glocklueng/bldc-hardware/design/BOM_2.xls

Mouser # | Description | Quant | Label on the Schematic/PCB | Comment | Price
511-STM32F407ZGT6 | STM32F4 MCU | 1 | U1
579-TC2117-3.3VDBTR | VREG | 1 | U2
595-DRV8302DCA | MOSFET Driver | 2 | U3
595-SN65HVD232DR | CAN Transceiver | 1 | U401
926-LM73CIMK-0/NOPB | Temp sensor | 4 | U301 | Only on REV 4.5. Rev 4.6 uses an NTC ressitor.
81-NCP18XH103F03RB | NTC resistor (temp sensor) | 4 | R1 | Rev 4.6 and onwards
652-SDR0805-220ML | Power Inductor | 2 | L1
798-UX60R-MB-5ST | Mini-USB | 1 | X1
815-ABM3B-8.0-10-1UT | Crystal 8MHz, 10PPM | 1 | X2
FDBL86210_F085 | MOSFET 150V 169A | 12 | Q1-Q6
71-WSLP27261L000FEA | Shunt 1mOhm | 6 | R53,R54
576-SMAJ5.0A | TVS diode 5V | 2 | D5 | Rev 4.7 and onwards
771-PMEG6020ER-115 | Shottky 60V 2A | 2 | D4 | Voltage and current important
581-TPSB107K006R0400 | CAP 100u, 6.3V | 4 | C25,C33 | Voltage important
963-UMK316BBJ106ML-T | CAP 10u, 50V, 1206 | 16 | C1,C8,C9,C39,C40,C43,C44,C49 | Voltage important
810-CGA9P3X7S2A156M | CAP 15u, 100V, 2220 | 4 | C37,C51 | Voltage important
581-06035C104JAT2A | CAP 100n, 50V, 0603 | 8 | C2,C3,C27,C32 | Voltage important
80-C0805C224K5 | CAP 220n, 25V, 0805 | 6 | C28,C29,C30 | Voltage important
810-C1608X5R1C225M | CAP 2.2u, 16V, 0603 | 30 | C24,C10,C11,C12,C13,C14,C16,C17,C20,C31,C35,C41,C52,C401 | Voltage important
77-VJ0805V225MXJTBC | CAP 2.2u, 16V, 0805 | 4 | C18,C23 | Voltage important
 | Micro-JST 6PIN 2mm | 6 | P1,P2,P3
 | Micro-JST 4PIN 2mm | 1 | P101
81-GRM39X472J50D | CAP 4.7n, 50V, 0603 | 12 | C4-C7
81-GRM39X222J50D | CAP 2.2n, 50V, 0603 | 4 | C34, C36
81-GRM1885C2A150JA01 | CAP 15p, 100V, 0603 | 4 | C15,C38
81-GRM39C121J50 | CAP 120p, 50V, 0603 | 2 | C19
81-GRM18R71H682KA01J | CAP 6.8n, 50V, 0603 | 2 | C21
81-GRM18F51H223ZA01D | CAP 22n, 50V, 0603 | 2 | C22
81-GRM155R71C104KA88 | CAP 100n, 16V, 0402 | 2 | C301
859-LTST-C191KGKT | LED Green, 0603 | 10 | D1
859-LTST-C191KRKT | LED Red, 0603 | 10 | D2
720-LBQ39GN1P1351 | LED Blue, 0603 | 10 | D3
660-RK73H1JTTD4R70F | R 4.7ohm, 0603 | 12 | R28,R29,R34,R35,R42,R43
660-RK73H1JTTD1000F | R 100ohm, 0603 | 14 | R37,R38,R48-R51,R401
660-RK73H1JTTD2201F | R 2.2k, 0603 | 18 | R4,R5,R11,R12,R13,R22,R24,R27,R33
660-RK73H1JTTD3301F | R 3.3k, 0603 | 2 | R18
660-RK73H1JTTD1002F | R 10k, 0603 | 18 | R2,R7,R8,R9,R10,R20,R402
660-RK73H1JTTD1502F | R 15k, 0603 | 2 | R19
660-RK73H1JTTD1802F | R 18k, 0603 | 2 | R17
71-CRCW0603J-33K | R 33k, 0603 | 28 | R3,R23,R26,R30,R32,R36,R46
660-RK73H1JTTD2203F | R 220k, 0603 | 2 | R21
660-RK73H1JTTD3303F | R 330k, 0603 | 2 | R15
660-RK73H1JTTD1004F | R 1M, 0603 | 2 | R25
660-RK73H1JTTD22R0F | R 22R, 0603 | 4 | R103, R104
 | ArduinoDUE | 1
