glocklueng/bldc-hardware/design/BLDC_4.pdf

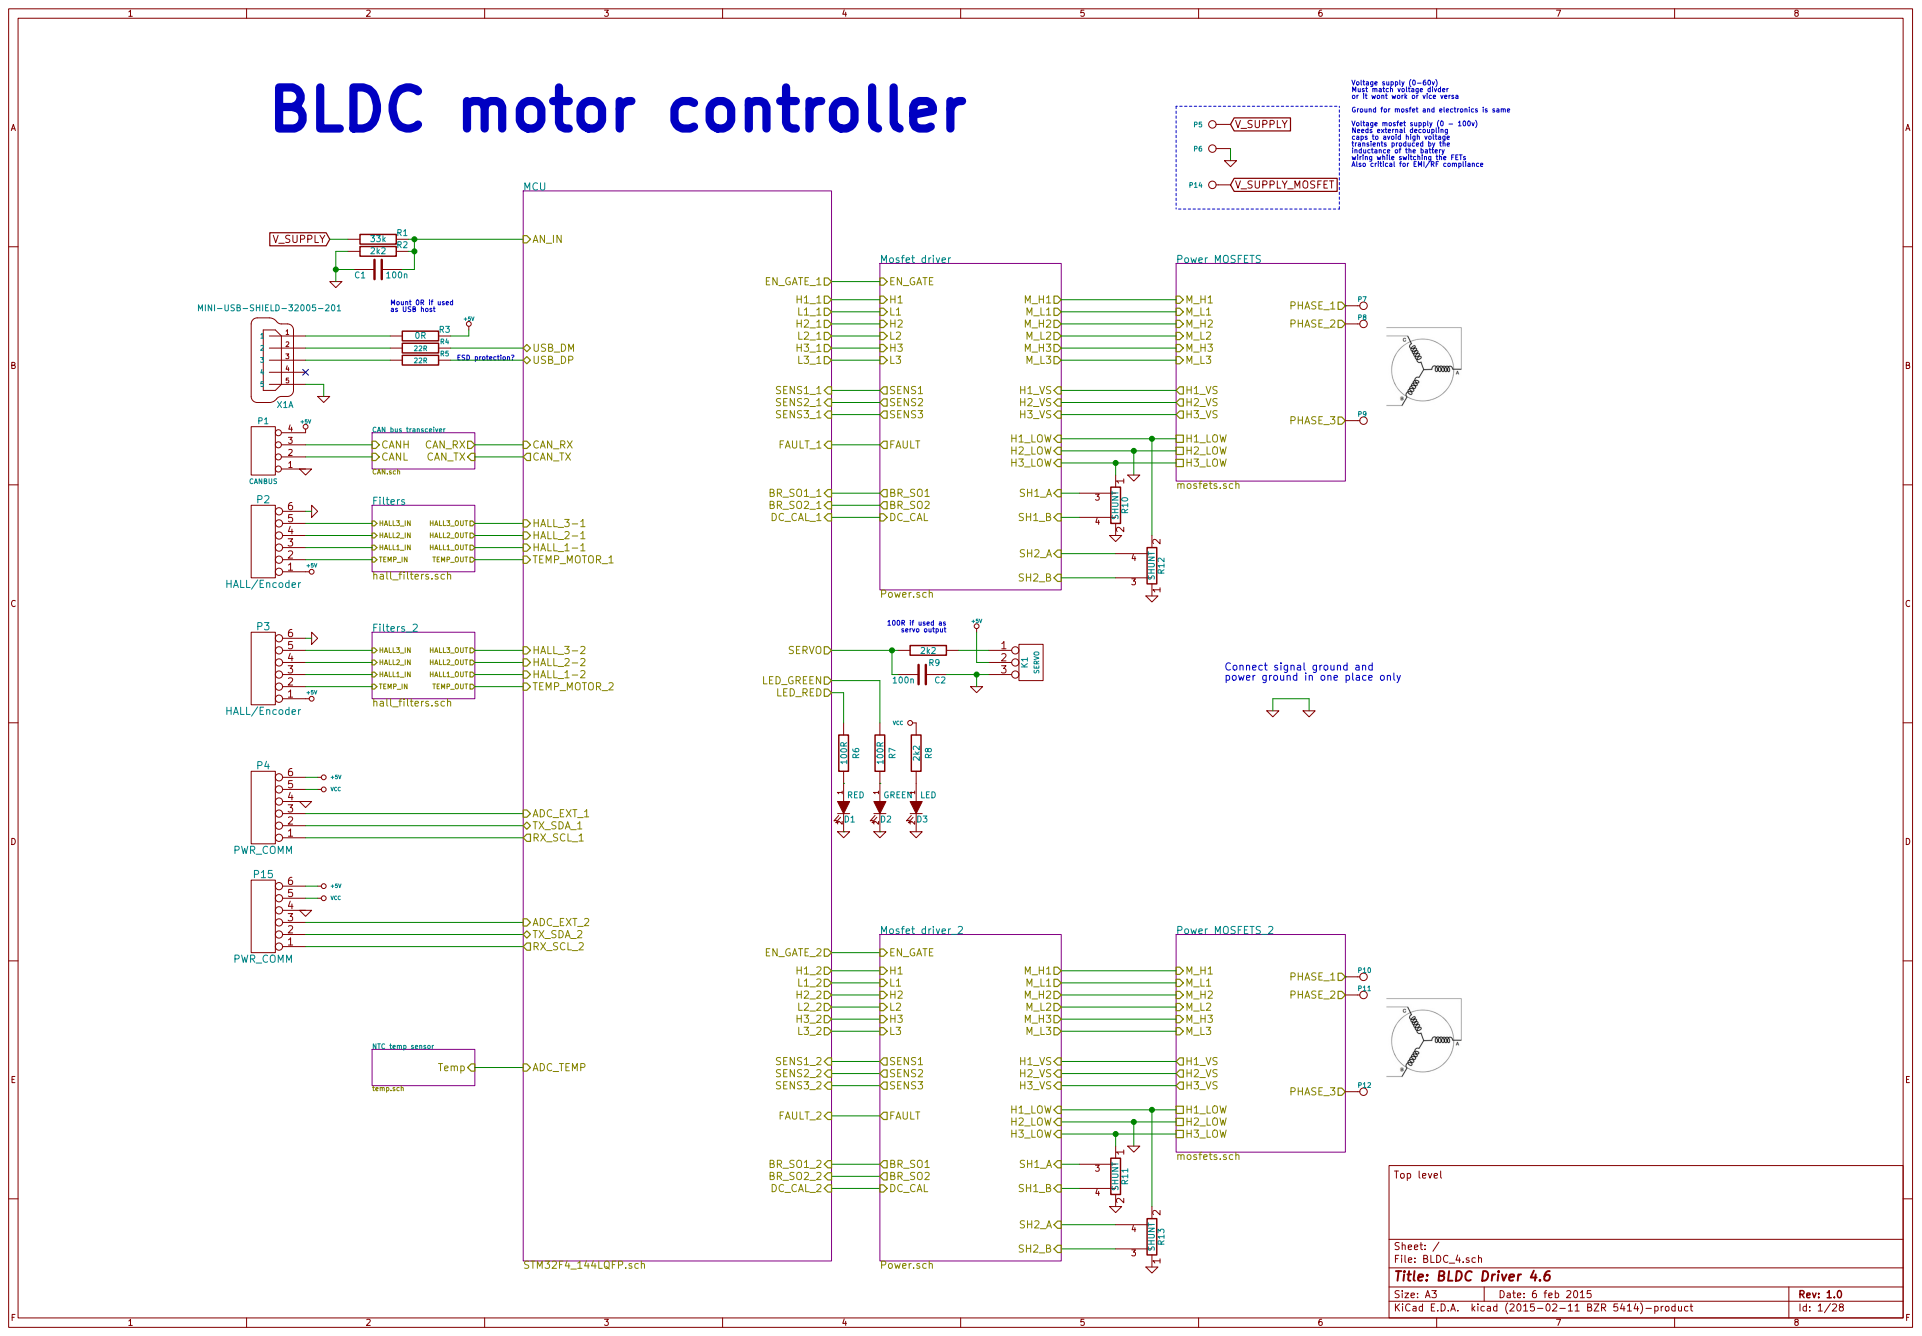
[picture p9: page 1]

Voltage mosfet supply (0 - 100v) Needs external decoupling
caps to avoid high voltage
transients produced by the

VCC Mosfet driver Power.sch FAULT DC_CAL
EN_GATE H1

File: BLDC_4.sch Sheet: / Top level 123456 P2 HALL/Encoder

power ground in one place only 123456 P3 HALL/Encoder

Connect signal ground and

Mosfet driver_2 Power.sch FAULT DC_CAL

Id: 1/28 Title: BLDC Driver 4.6

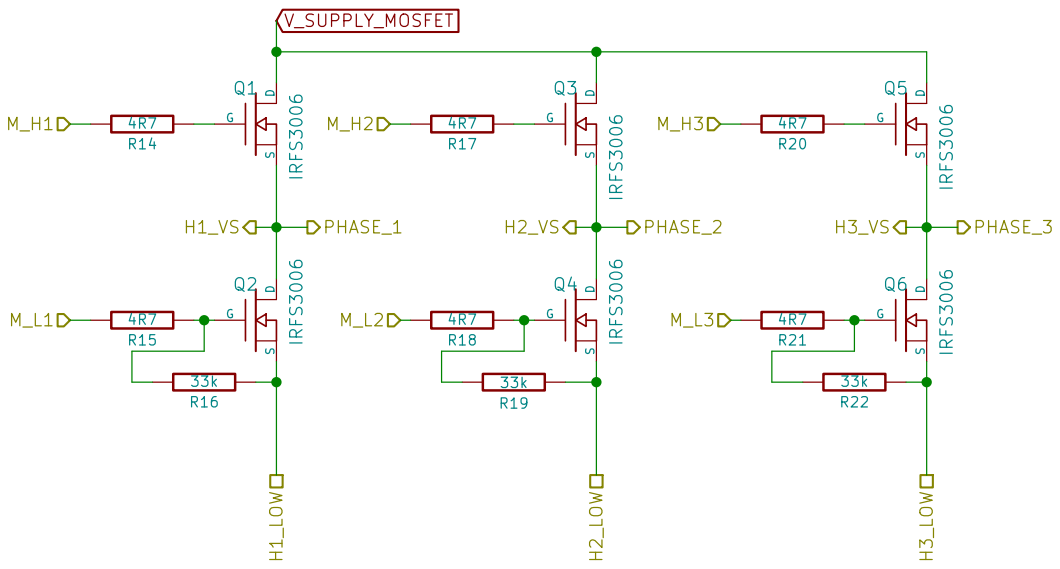
[picture p10: page 2]

33k V_SUPPLY_MOSFET
File: mosfets.sch Sheet: /Power MOSFETS/ R22

Id: 2/28 Title: BLDC Driver 4.6

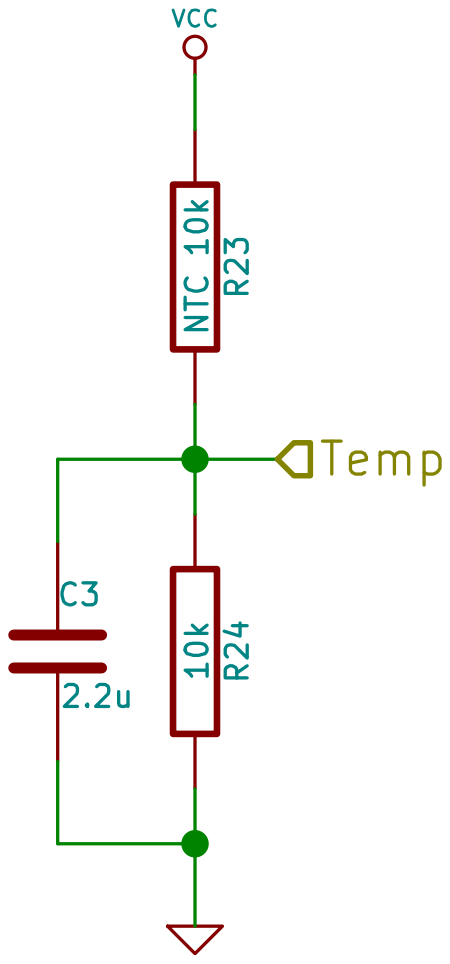
[picture p11: page 3]

Sheet: /NTC temp sensor/ R23 NTC 10k 10k R24 C3

File: temp.sch
Id: 3/28 Title: NTC resistor temperature sensor

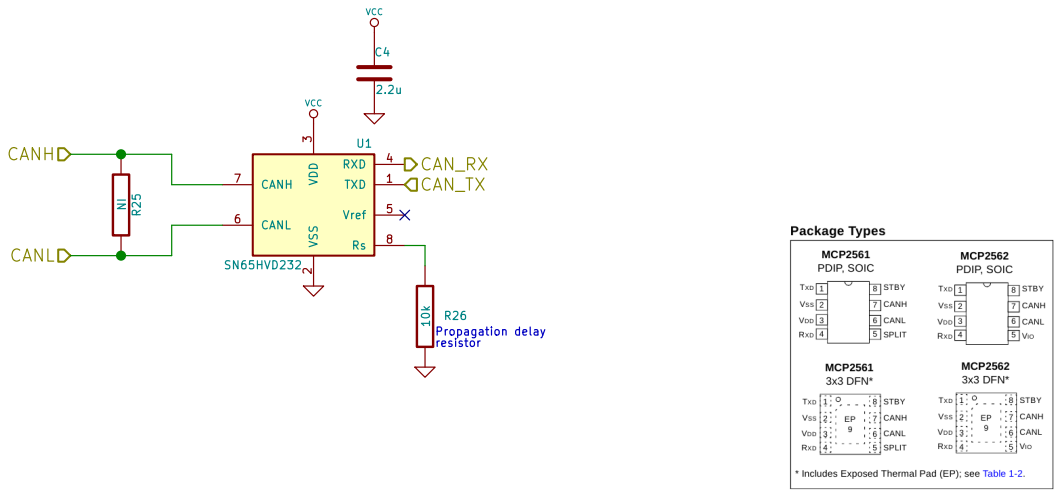
[picture p12: page 4]

3 RXD 4 Vref 5 CANL 6 CANH 7 Rs 8 U1 SN65HVD232

Id: 4/28 Title: CAN BUS transceiver File: CAN.sch Sheet: /CAN bus transceiver/

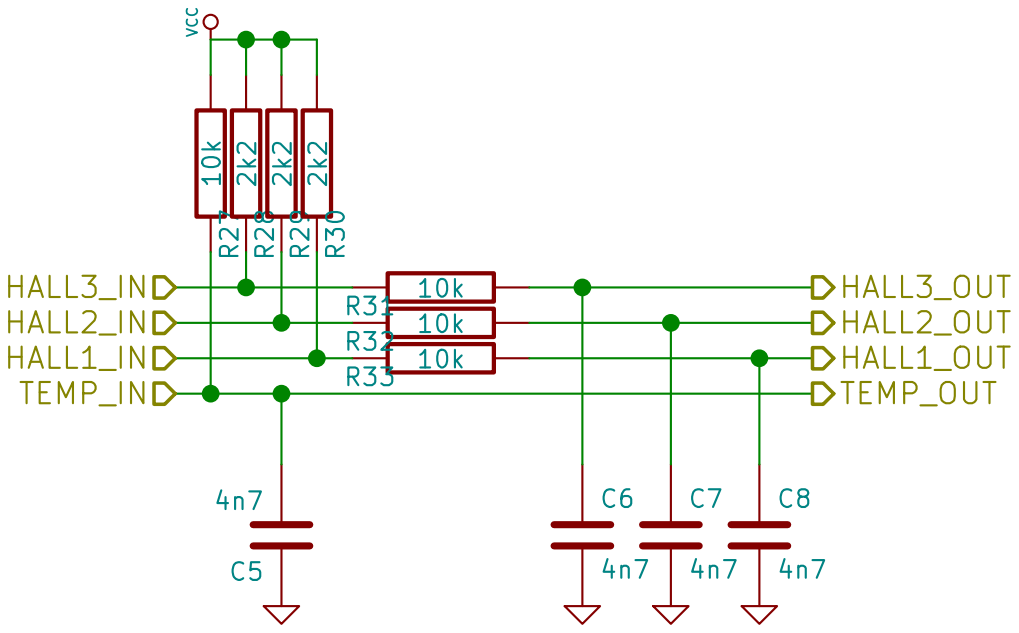
[picture p13: page 5]

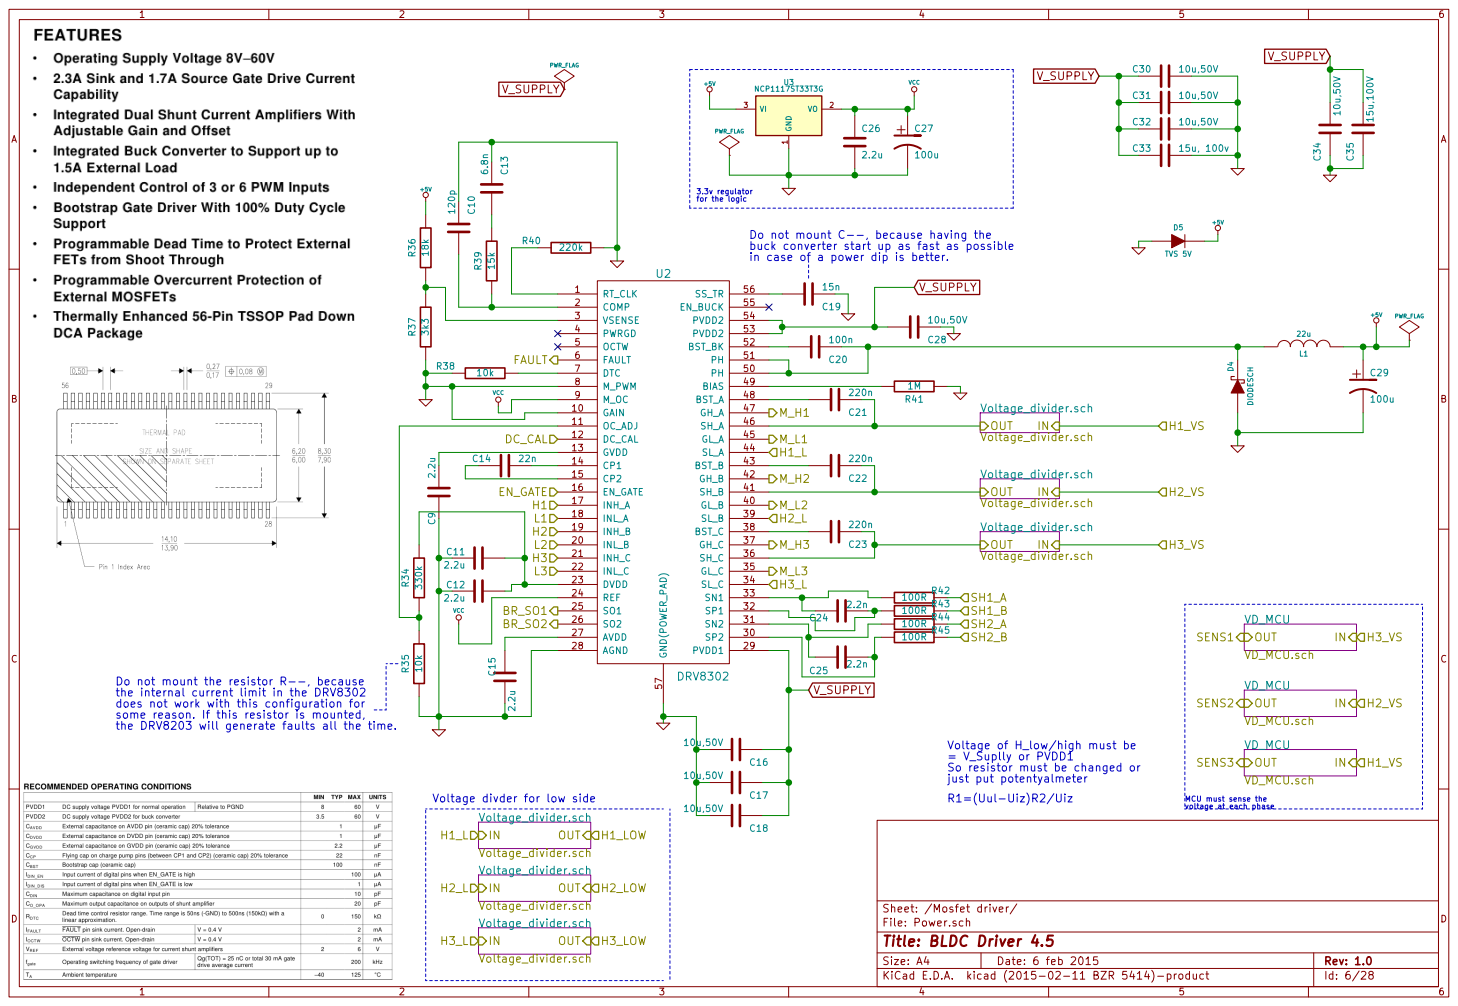
[picture p14: page 6]

for the logic Do not mount the resistor R--, because

+5V Do not mount C--, because having the
buck converter start up as fast as possible
in case of a power dip is better.

the internal current limit in the DRV8302
does not work with this configuration for
some reason. If this resistor is mounted,
the DRV8203 will generate faults all the time.

Voltage of H_low/high must be
= V_Suplly or PVDD1
So resistor must be changed or
just put potentyalmeter
R1=(Uul-Uiz)R2/Uiz

Voltage divder for low side

MCU must sense the
voltage at each phase

File: Power.sch Sheet: /Mosfet driver/
Id: 6/28 Title: BLDC Driver 4.5

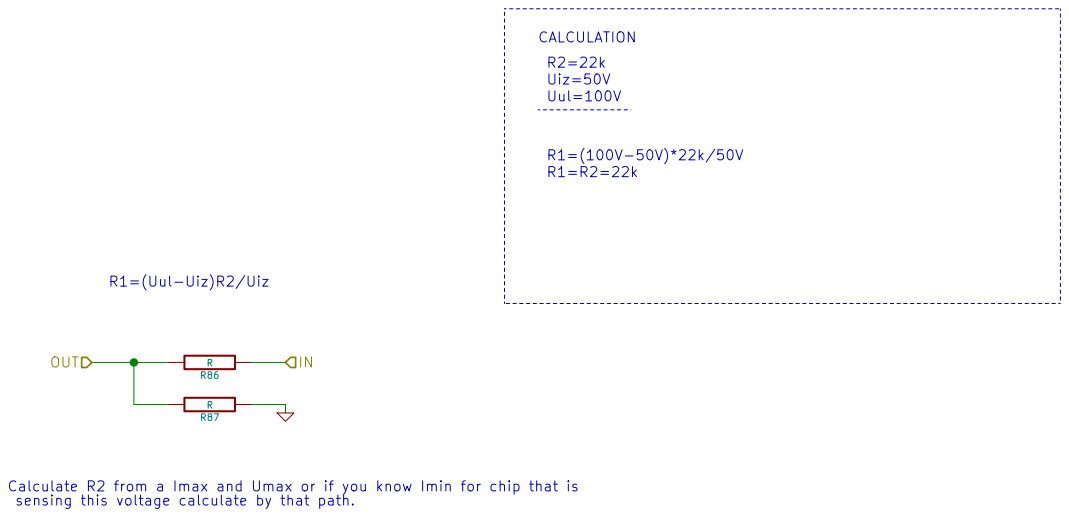
[picture p15: page 7]

Calculate R2 from a Imax and Umax or if you know Imin for chip that is
sensing this voltage calculate by that path.

Sheet: /Mosfet driver/Voltage_divider.sch/
File: Voltage_divider.sch
Id: 7/28 Title:

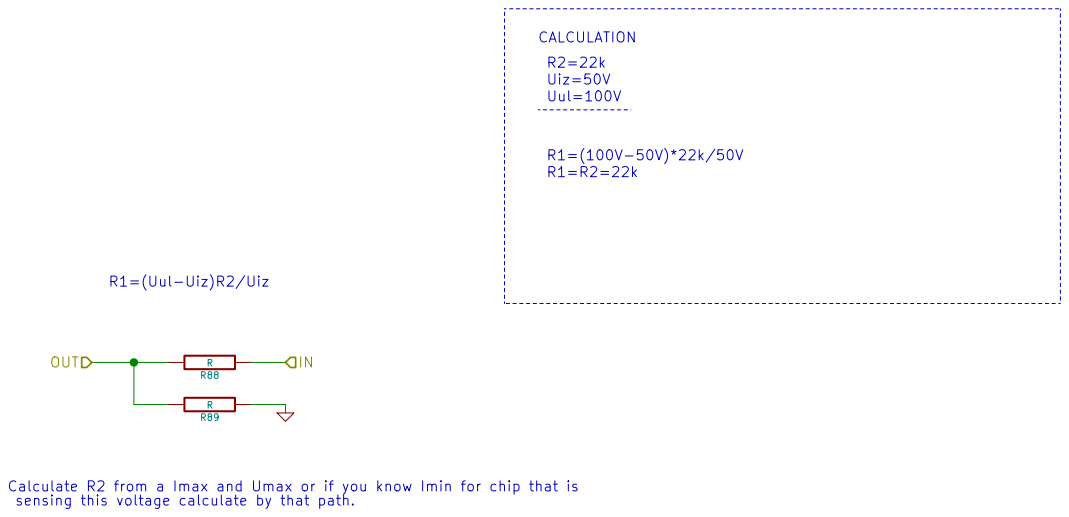
[picture p16: page 8]
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

Sheet: /Mosfet driver/Voltage_divider.sch/
File: Voltage_divider.sch
Id: 8/28 Title:

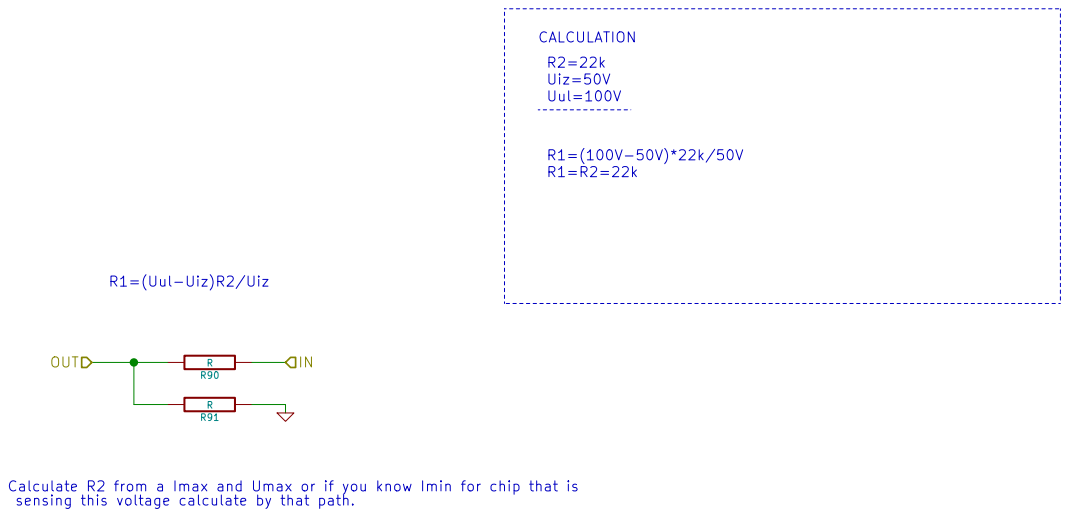
[picture p17: page 9]
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

Sheet: /Mosfet driver/Voltage_divider.sch/
File: Voltage_divider.sch
Id: 9/28 Title:

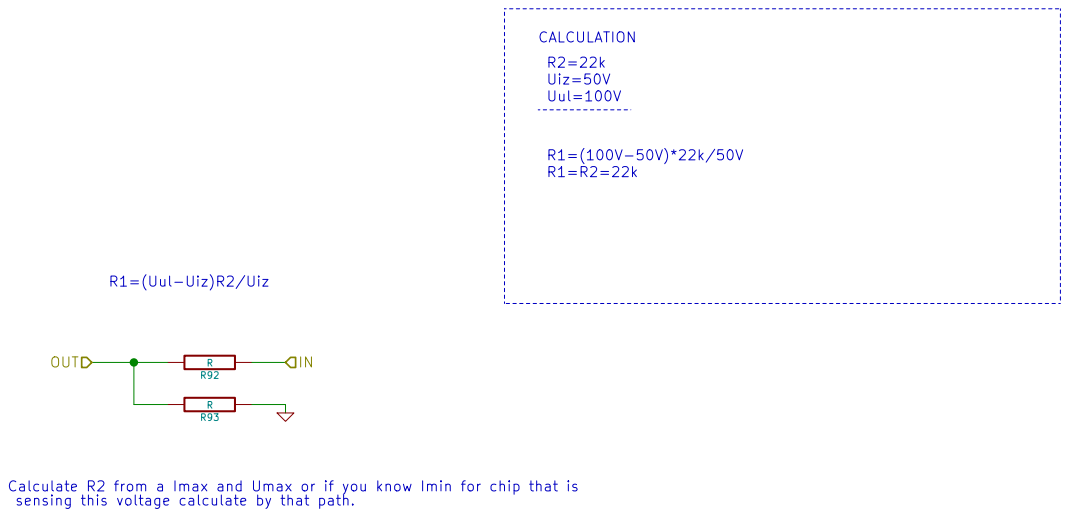
[picture p18: page 10]
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

Sheet: /Mosfet driver/Voltage_divider.sch/
File: Voltage_divider.sch
Id: 10/28 Title:

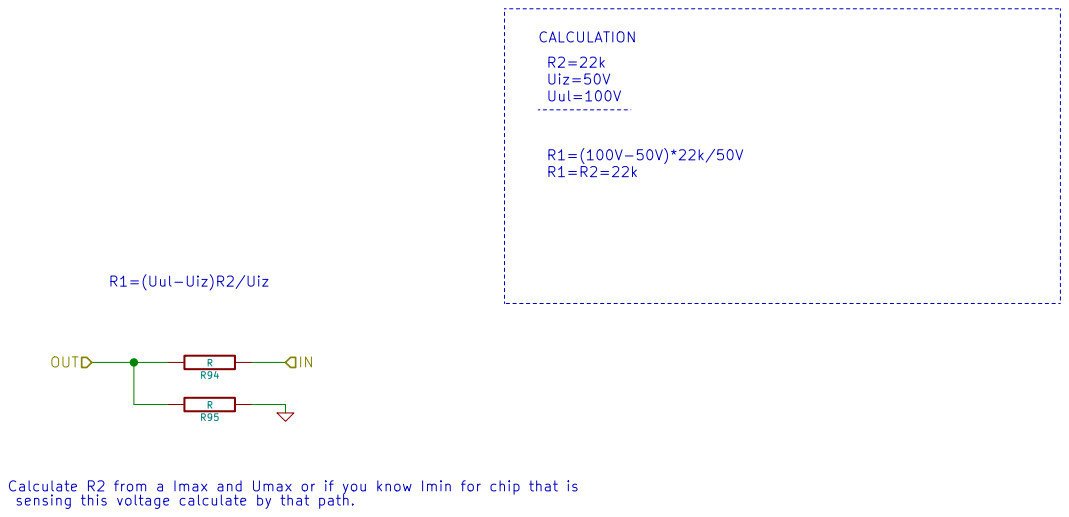
[picture p19: page 11]
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

Sheet: /Mosfet driver/Voltage_divider.sch/
File: Voltage_divider.sch
Id: 11/28 Title:

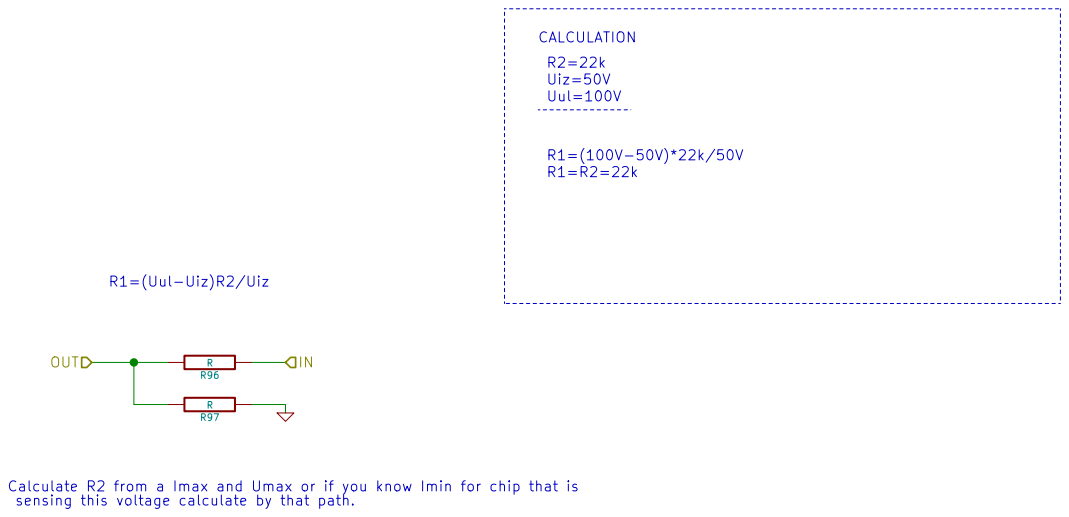
[picture p20: page 12]
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

Sheet: /Mosfet driver/Voltage_divider.sch/
File: Voltage_divider.sch
Id: 12/28 Title:

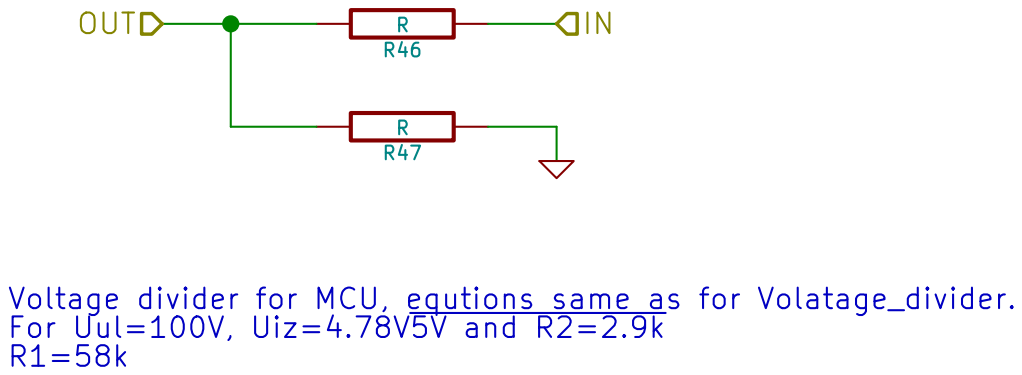
[picture p21: page 13]

Voltage divider for MCU, equtions same as for Volatage_divider.
For Uul=100V, Uiz=4.78V5V and R2=2.9k R1=58k

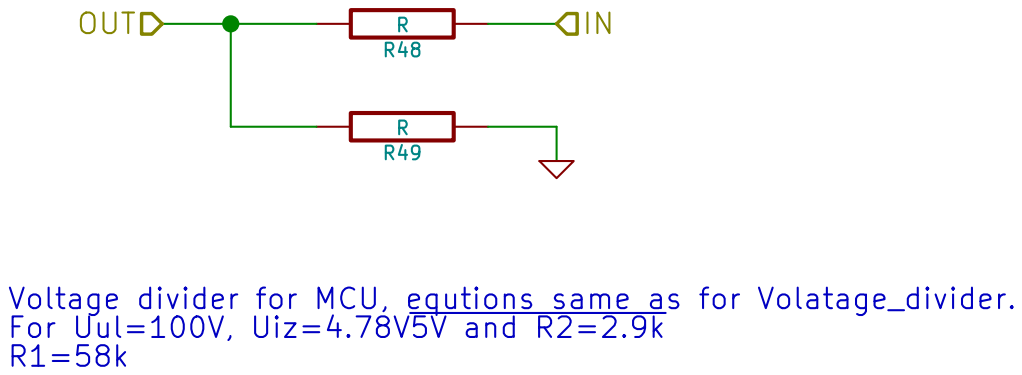
[picture p22: page 14]
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

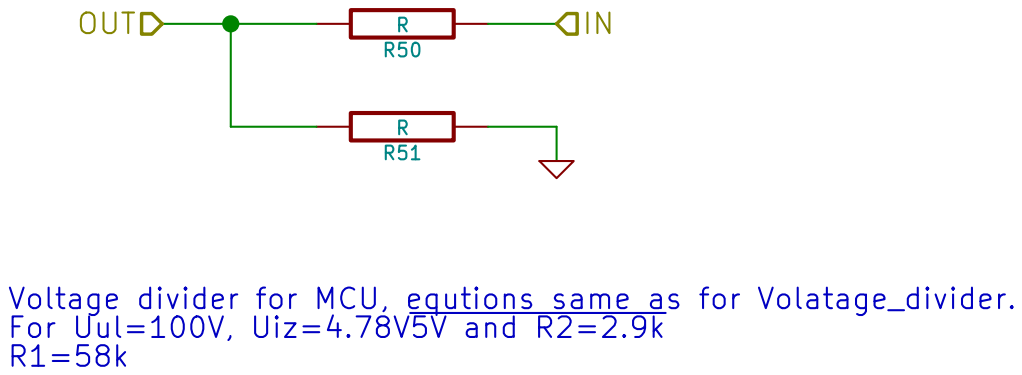
[picture p23: page 15]
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

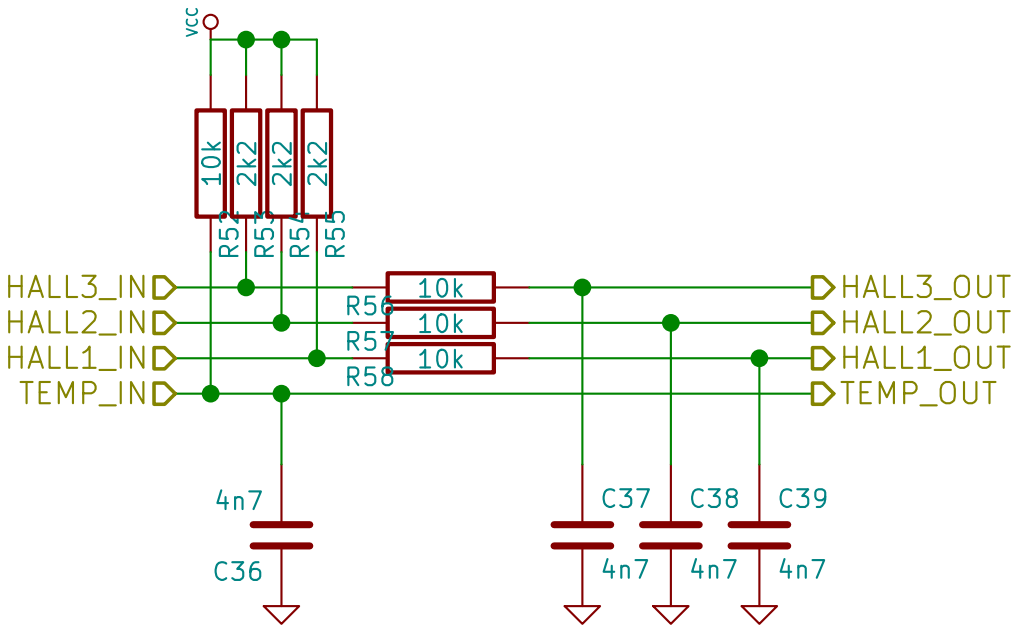
[picture p24: page 16]

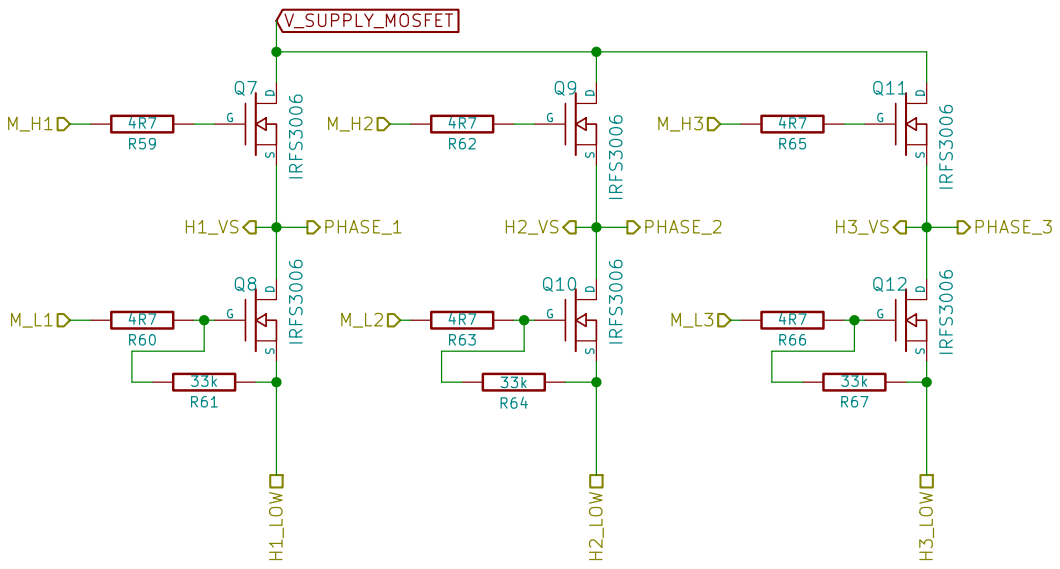
[picture p25: page 17]

33k V_SUPPLY_MOSFET
File: mosfets.sch Sheet: /Power MOSFETS_2/ R67

Id: 17/28 Title: BLDC Driver 4.6

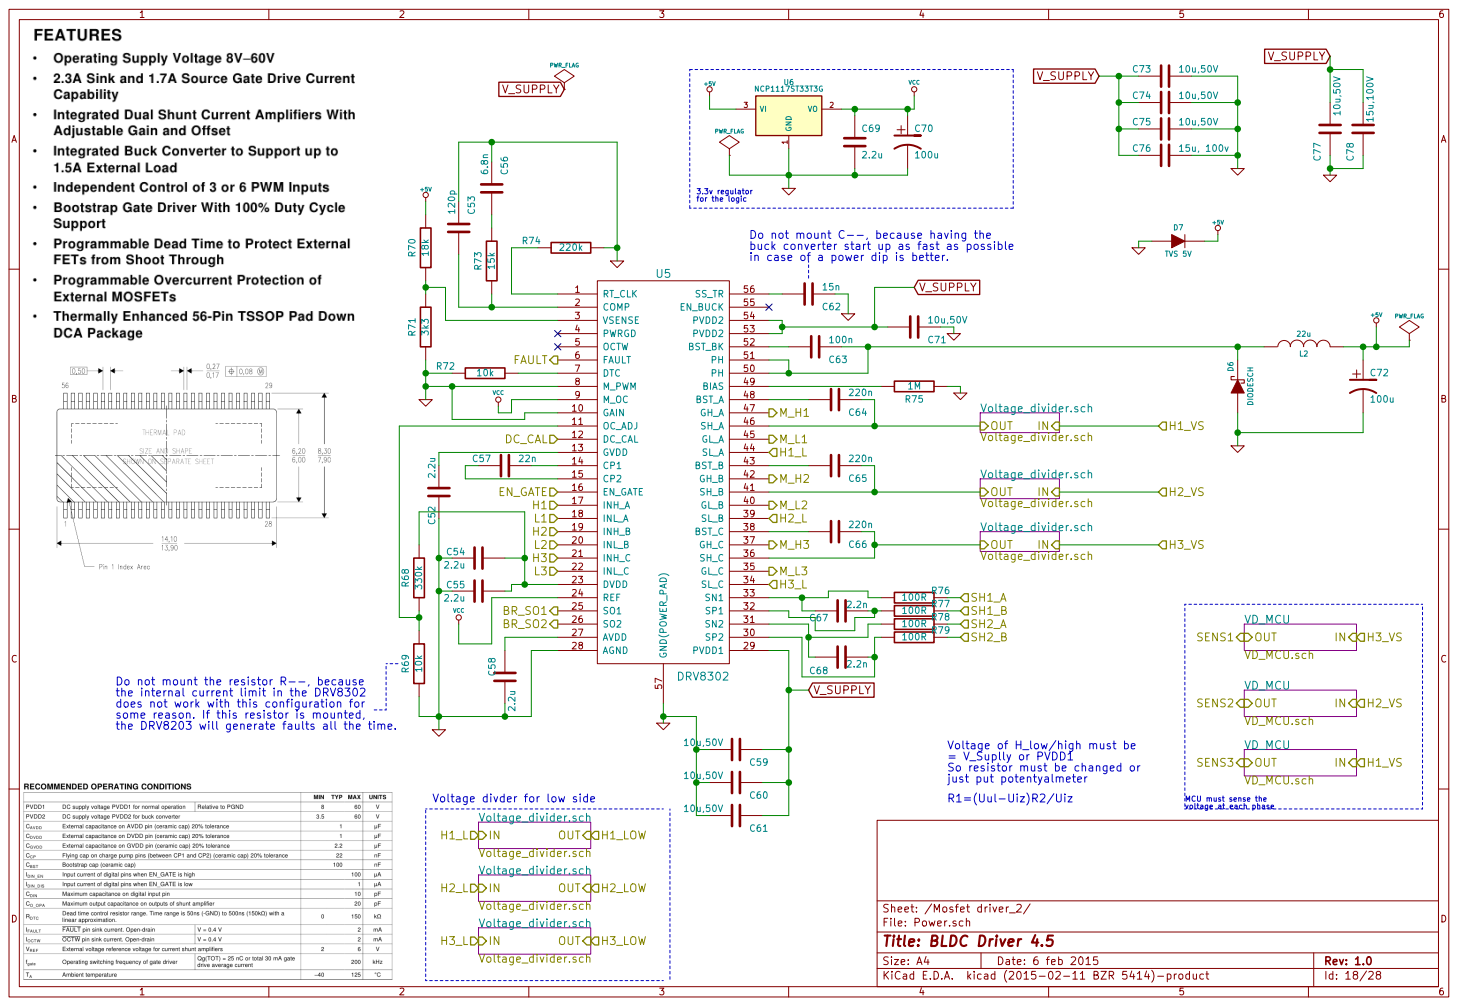
[picture p26: page 18]

for the logic Do not mount the resistor R--, because

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

Voltage divder for low side

MCU must sense the
voltage at each phase

File: Power.sch Sheet: /Mosfet driver_2/
Id: 18/28 Title: BLDC Driver 4.5

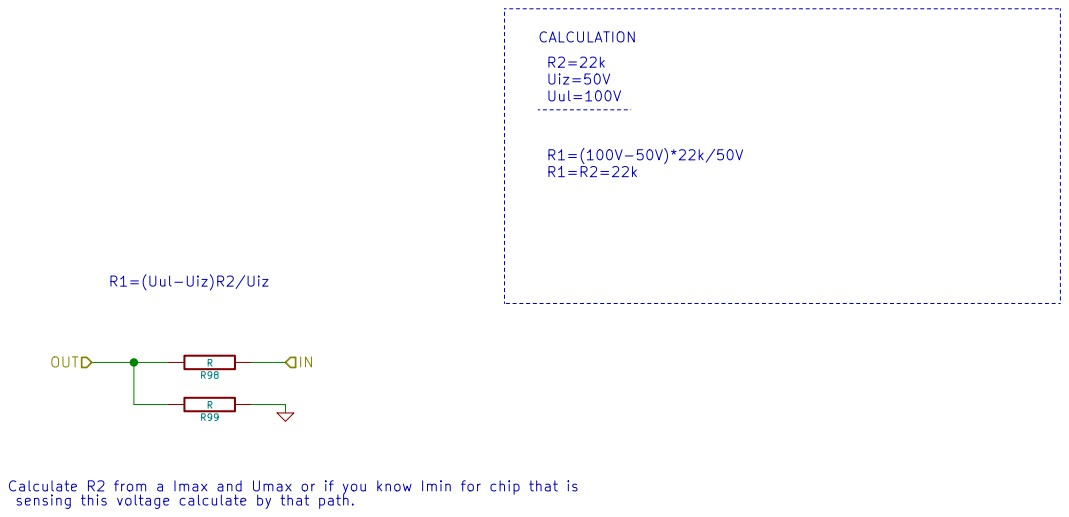
[picture p27: page 19]
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

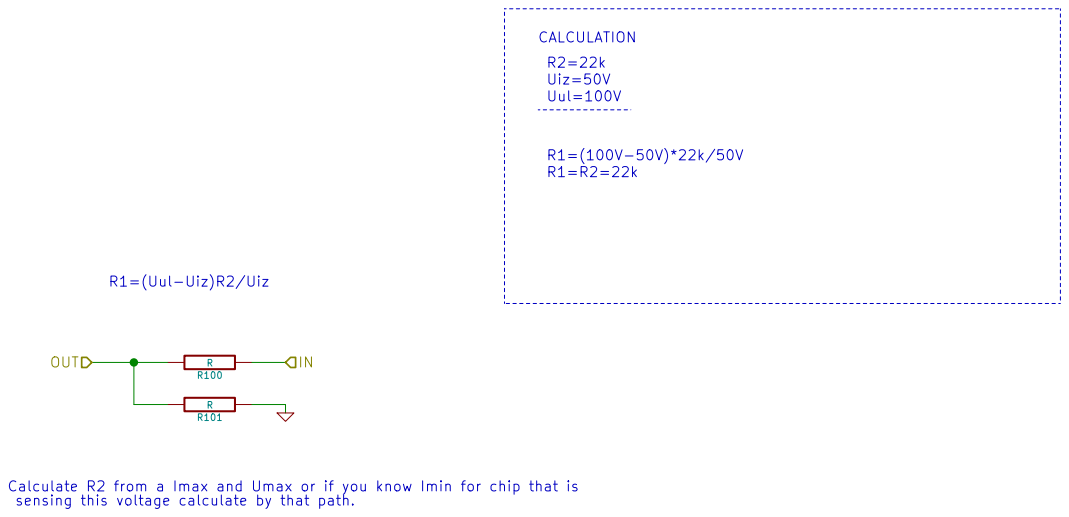
[picture p28: page 20]
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

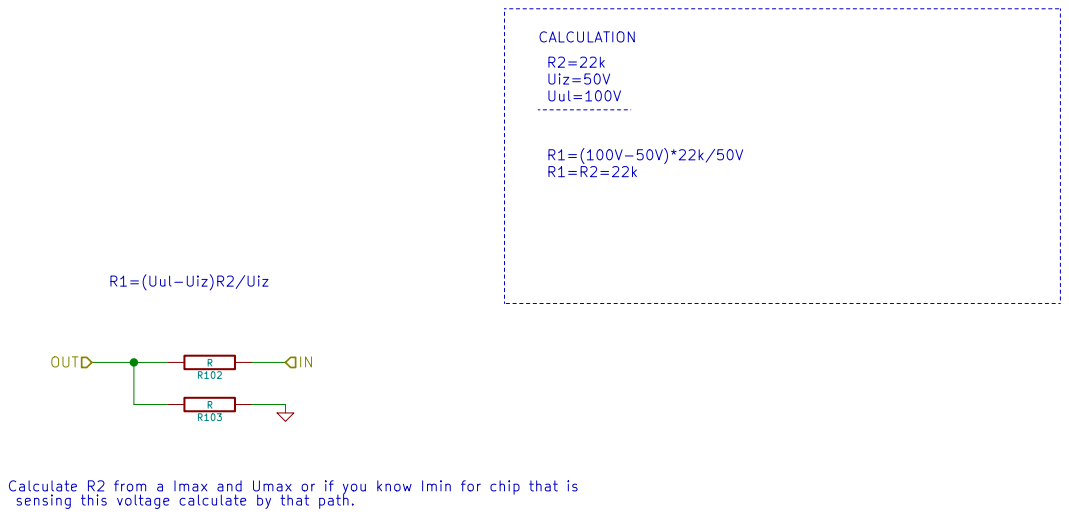
[picture p29: page 21]
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

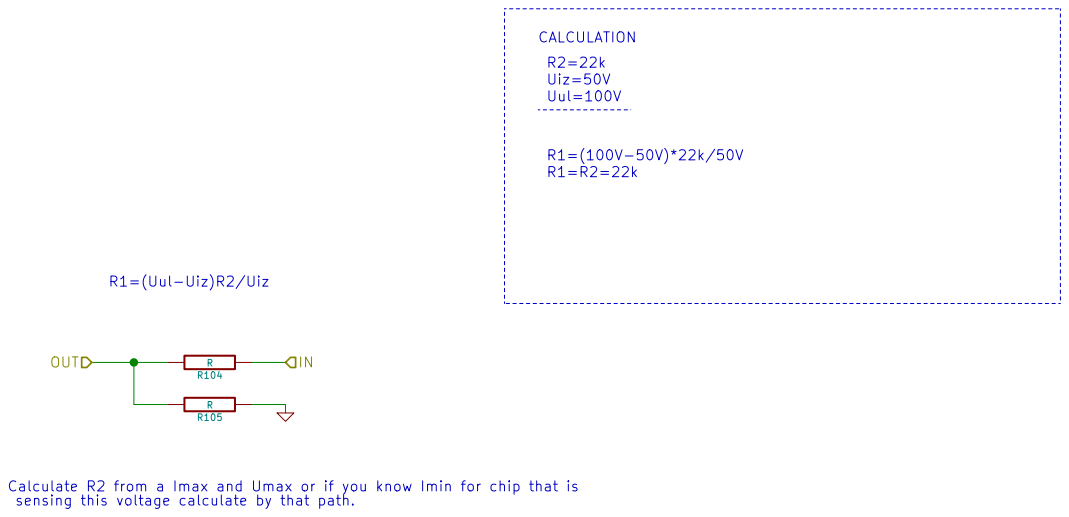
[picture p30: page 22]
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

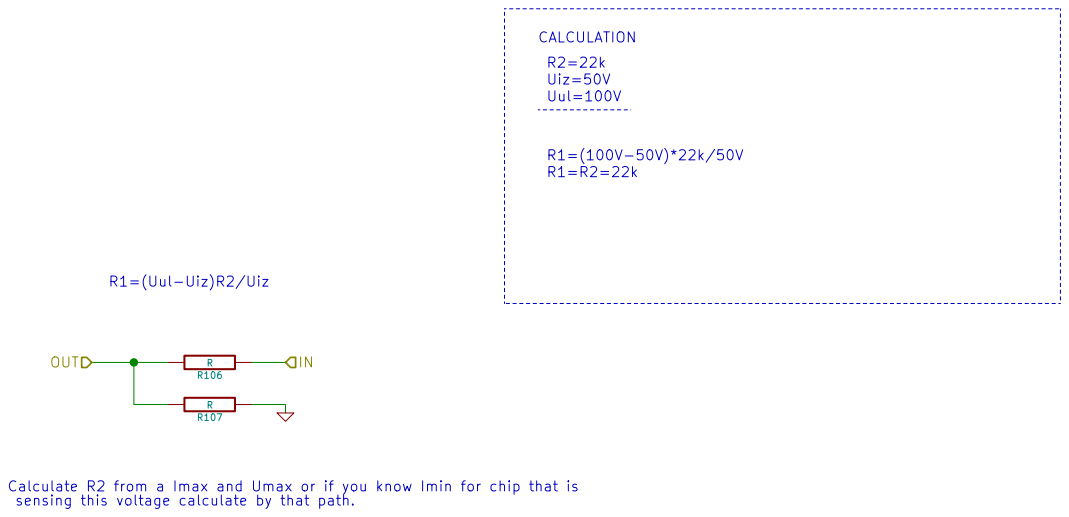
[picture p31: page 23]
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

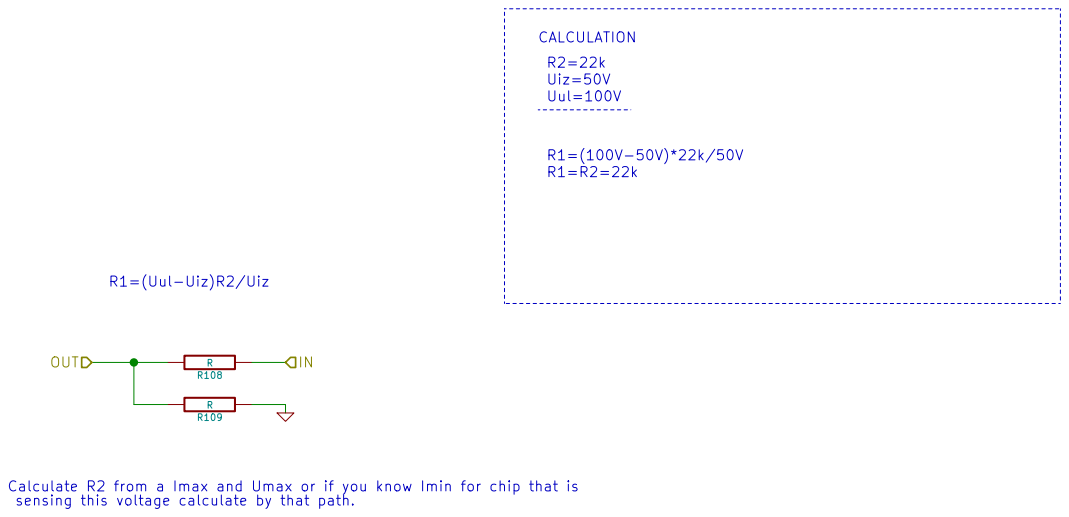
[picture p32: page 24]
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

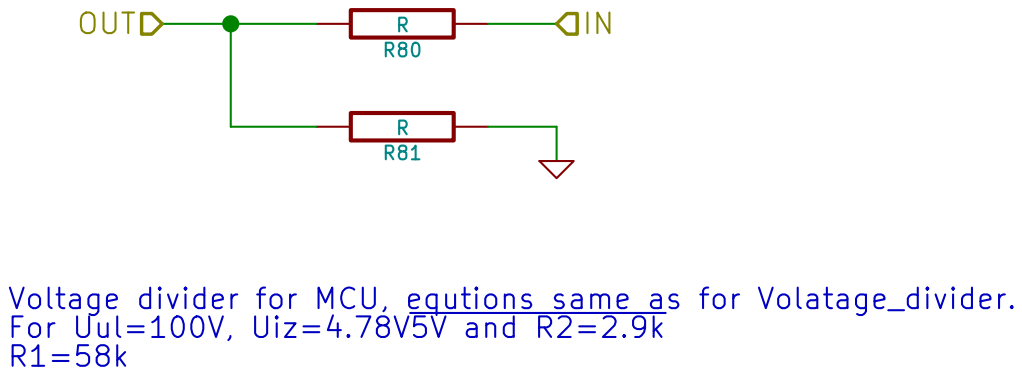
[picture p33: page 25]
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

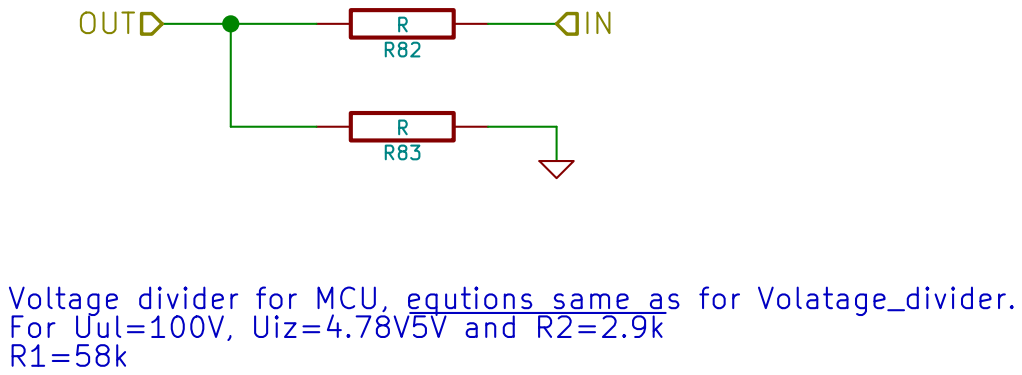
[picture p34: page 26]
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

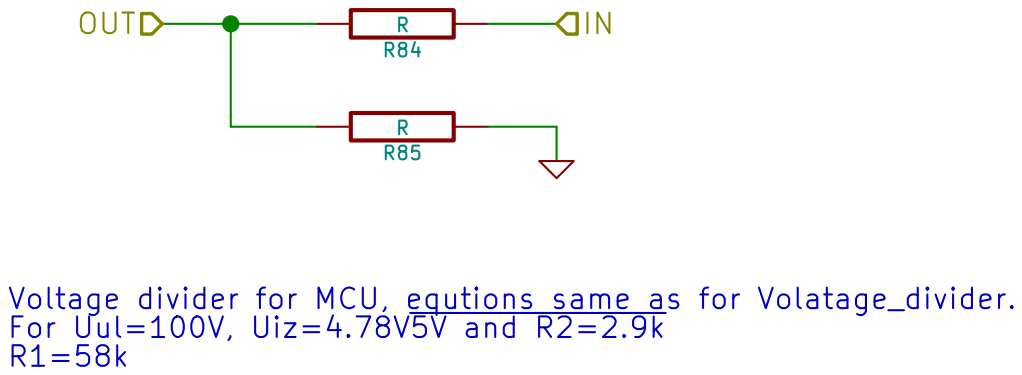
[picture p35: page 27]
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

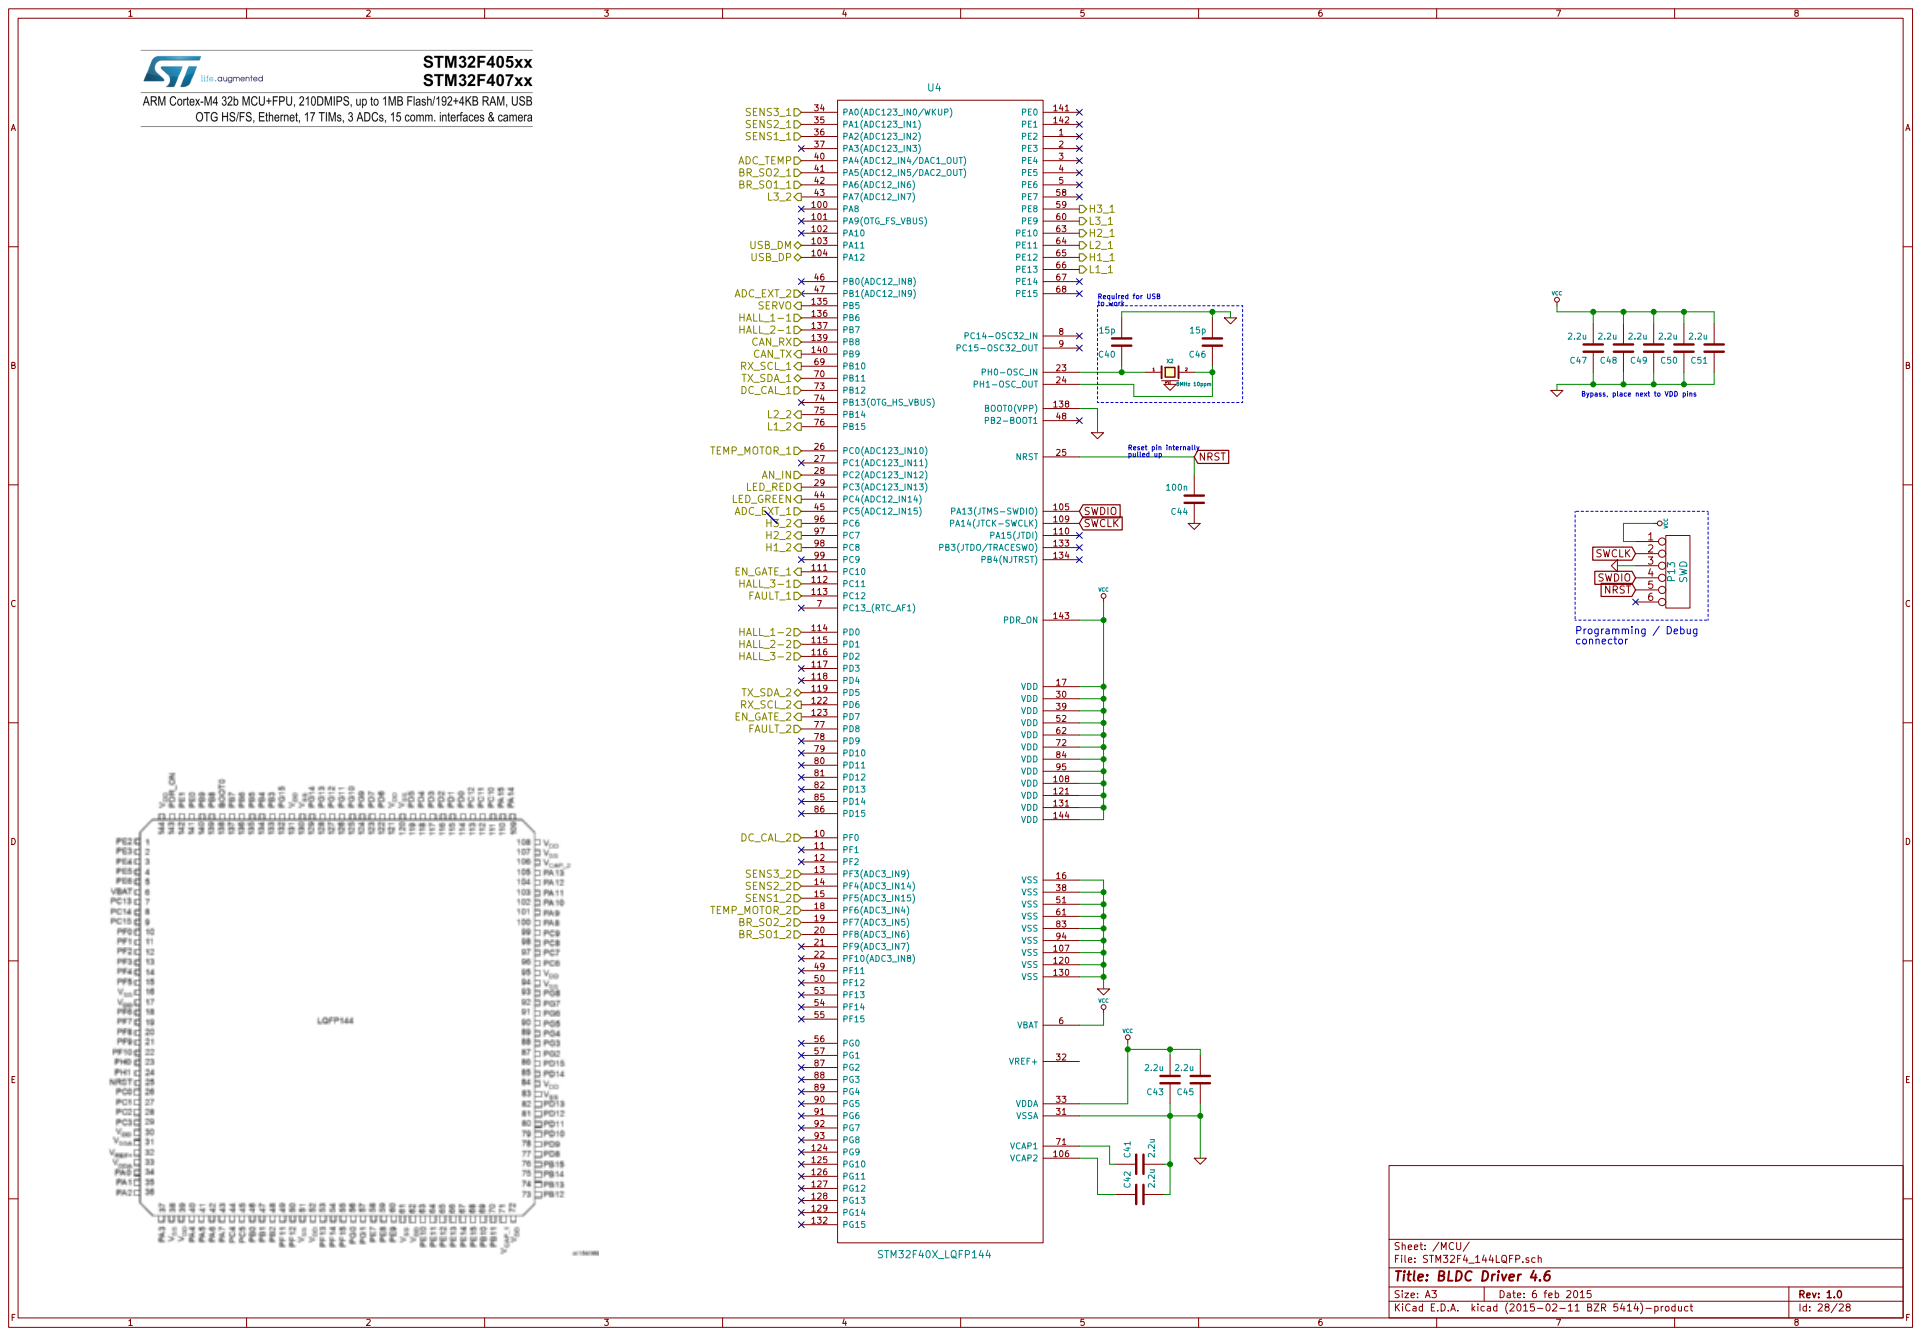
[picture p36: page 28]

Id: 28/28 Title: BLDC Driver 4.6
