glocklueng/bldc-hardware/(list of files, drawings)

Other design files:
design/BLDC_4.dsn
