glocklueng/bldc-hardware/design/BLDC_4.kicad_pcb

## KiCad design design/BLDC_4.kicad_pcb (2015-03-07)

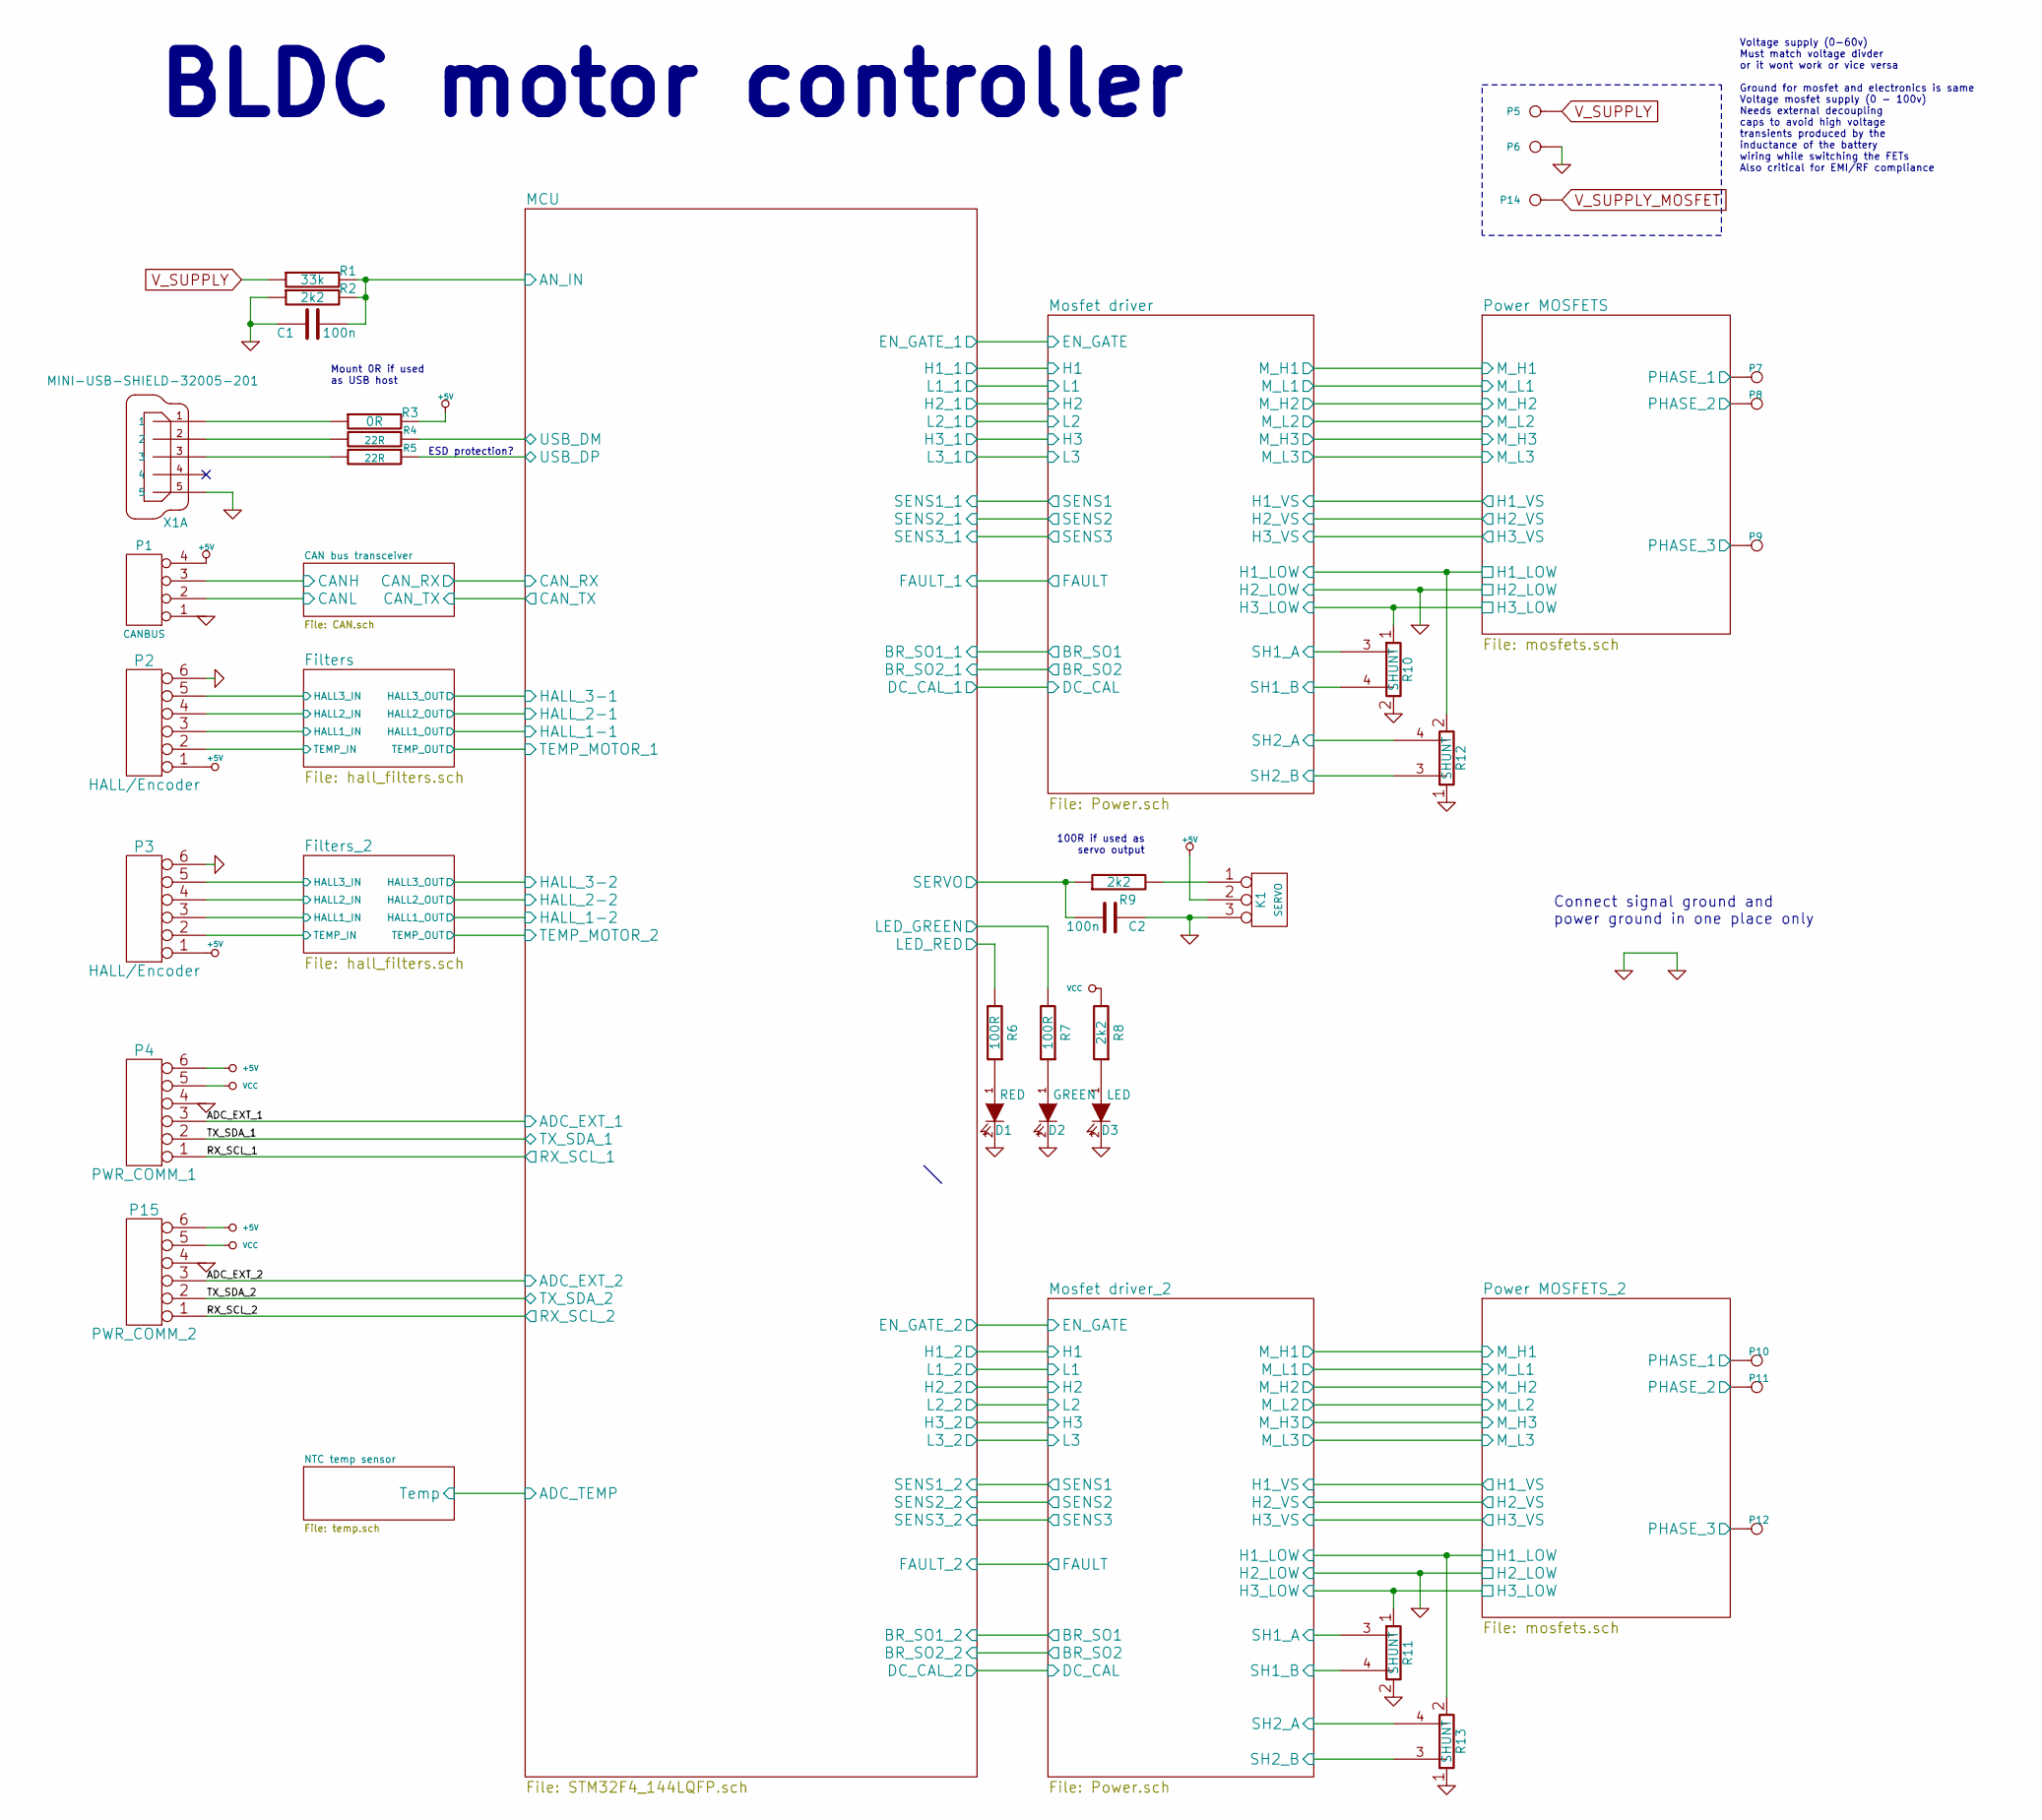
[picture p37: schematic BLDC_4.sch, BLDC Driver 4.6]

Parts:
C1, C2: 100n; SMD-0603_c
D1: RED; LED-0603
D2: GREEN; LED-0603
D3: LED; LED-0603
K1: SERVO; pinhead-1X03
P1: CANBUS; pinhead-1X04
P2, P3: HALL/Encoder; MICRO_JST_6
P4: PWR_COMM_1; MICRO_JST_6
P5, P14: IN+; 1PAD_4x5mm
P6: IN-; 1PAD_4x5mm
P7, P10: MOTOR3; 1PAD_4x5mm
P8, P11: MOTOR2; 1PAD_4x5mm
P9, P12: MOTOR1; 1PAD_4x5mm
P15: PWR_COMM_2; MICRO_JST_6
R1: 33k; SMD-0603_r
R2, R8, R9: 2k2; SMD-0603_r
R3: 0R; SMD-0603_r
R4, R5: 22R; SMD-0603_r
R6, R7: 100R; SMD-0603_r
R10, R11, R12, R13: SHUNT; WSLP2726
X1: MINI-USB-SHIELD-32005-201; con-cypressindustries-32005-201

Connections:
+5V: K1.2 (PM), P1.4, P2.1, P3.1, P4.6, P15.6, R3.2; also elsewhere on the board
/CAN bus transceiver/CANH: P1.3; also elsewhere on the board
/CAN bus transceiver/CANL: P1.2; also elsewhere on the board
/Filters/HALL1_IN: P2.3; also elsewhere on the board
/Filters/HALL2_IN: P2.4; also elsewhere on the board
/Filters/HALL3_IN: P2.5; also elsewhere on the board
/Filters/TEMP_IN: P2.2; also elsewhere on the board
/Filters_2/HALL1_IN: P3.3; also elsewhere on the board
/Filters_2/HALL2_IN: P3.4; also elsewhere on the board
/Filters_2/HALL3_IN: P3.5; also elsewhere on the board
/Filters_2/TEMP_IN: P3.2; also elsewhere on the board
/MCU/ADC_EXT_1: P4.3; also elsewhere on the board
/MCU/ADC_EXT_2: P15.3; also elsewhere on the board
/MCU/AN_IN: C1.2, R1.2, R2.2; also elsewhere on the board
/MCU/LED_GREEN: R7.2; also elsewhere on the board
/MCU/LED_RED: R6.2; also elsewhere on the board
/MCU/RX_SCL_1: P4.1; also elsewhere on the board
/MCU/RX_SCL_2: P15.1; also elsewhere on the board
/MCU/SERVO: C2.2, R9.1; also elsewhere on the board
/MCU/TX_SDA_1: P4.2; also elsewhere on the board
/MCU/TX_SDA_2: P15.2; also elsewhere on the board
/MCU/USB_DM: R4.1; also elsewhere on the board
/MCU/USB_DP: R5.1; also elsewhere on the board
/Mosfet driver/H3_VS: P9.1; also elsewhere on the board
/Mosfet driver/SH1_A: R10.3; also elsewhere on the board
/Mosfet driver/SH1_B: R10.4; also elsewhere on the board
/Mosfet driver/SH2_A: R12.4; also elsewhere on the board
/Mosfet driver/SH2_B: R12.3; also elsewhere on the board
/Mosfet driver_2/H3_VS: P12.1; also elsewhere on the board
/Mosfet driver_2/SH1_A: R11.3; also elsewhere on the board
/Mosfet driver_2/SH1_B: R11.4; also elsewhere on the board
/Mosfet driver_2/SH2_A: R13.4; also elsewhere on the board
/Mosfet driver_2/SH2_B: R13.3; also elsewhere on the board
GND: C1.1, C2.1, D1.2 (K), D2.2 (K), D3.2 (K), K1.3, P1.1, P2.6, P3.6, P4.4, P6.1, P15.4, R2.1, R10.2, R11.2, R12.1, R13.1, X1.5; also elsewhere on the board
unnamed: D1.1 (A), R6.1
unnamed: D2.1 (A), R7.1
unnamed: D3.1 (A), R8.1
unnamed: K1.1, R9.2
unnamed: R3.1, X1.1
unnamed: R4.2, X1.2
unnamed: R5.2, X1.3
VCC: P4.5, P15.5, R8.2; also elsewhere on the board
V_SUPPLY: P5.1, R1.1; also elsewhere on the board
V_SUPPLY_MOSFET: P14.1; also elsewhere on the board

Notes on the sheet:
100R if used as servo output
Mount 0R if used as USB host
ESD protection?
BLDC motor controller
Voltage mosfet supply (0 - 100v) Needs external decoupling caps to avoid high voltage transients produced by the inductance of the battery wiring while switching the FETs Also critical for EMI/RF compliance
Connect signal ground and power ground in one place only
Voltage supply (0-60v) Must match voltage divder or it wont work or vice versa Ground for mosfet and electronics is same

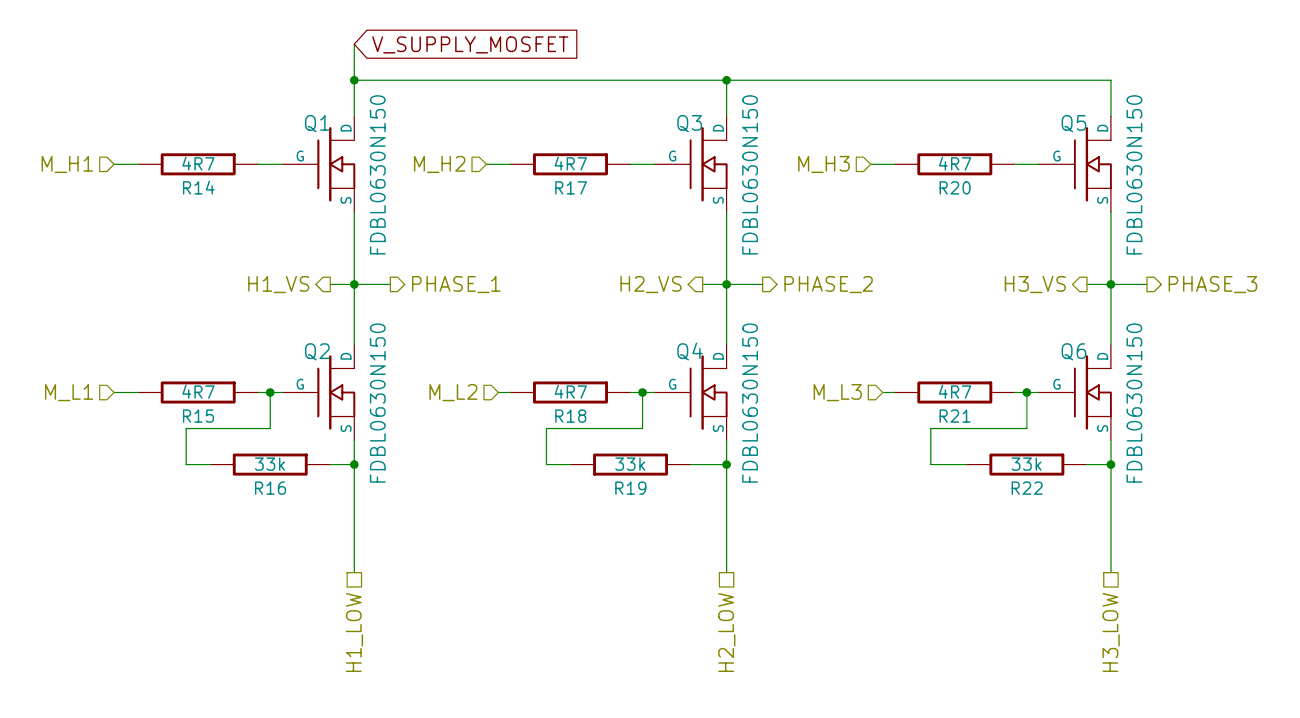
[picture p38: schematic mosfets.sch, BLDC Driver 4.6]

Parts:
Q2, Q3, Q5, Q6, Q7, Q10: FDBL0630N150; H-PSOF-8L
R59, R60, R62, R63, R65, R66: 4R7; SMD-0603_r
R61, R64, R67: 33k; SMD-0603_r

Connections:
/Mosfet driver/H3_VS: Q5.S, Q6.D; also elsewhere on the board
/Mosfet driver_2/M_H1: R59.2; also elsewhere on the board
/Mosfet driver_2/M_H2: R62.2; also elsewhere on the board
/Mosfet driver_2/M_H3: R65.2; also elsewhere on the board
/Mosfet driver_2/M_L1: R60.2; also elsewhere on the board
/Mosfet driver_2/M_L2: R63.2; also elsewhere on the board
/Mosfet driver_2/M_L3: R66.2; also elsewhere on the board
GND: Q10.S, R64.2; also elsewhere on the board
unnamed: Q7.G, R59.1
unnamed: Q10.G, R63.1, R64.1
V_SUPPLY_MOSFET: Q3.D, Q5.D, Q7.D; also elsewhere on the board

Parts of its further copies:
Q1, Q4, Q8, Q9, Q11, Q12: FDBL0630N150; H-PSOF-8L
R14, R15, R17, R18, R20, R21: 4R7; SMD-0603_r
R16, R19, R22: 33k; SMD-0603_r

Connections of its further copies:
/Mosfet driver/M_H1: R14.2; also elsewhere on the board
/Mosfet driver/M_H2: R17.2; also elsewhere on the board
/Mosfet driver/M_H3: R20.2; also elsewhere on the board
/Mosfet driver/M_L1: R15.2; also elsewhere on the board
/Mosfet driver/M_L2: R18.2; also elsewhere on the board
/Mosfet driver/M_L3: R21.2; also elsewhere on the board
/Mosfet driver_2/H3_VS: Q11.S, Q12.D; also elsewhere on the board
GND: Q4.S, R19.2; also elsewhere on the board
unnamed: Q1.G, R14.1
unnamed: Q4.G, R18.1, R19.1
V_SUPPLY_MOSFET: Q1.D, Q9.D, Q11.D; also elsewhere on the board

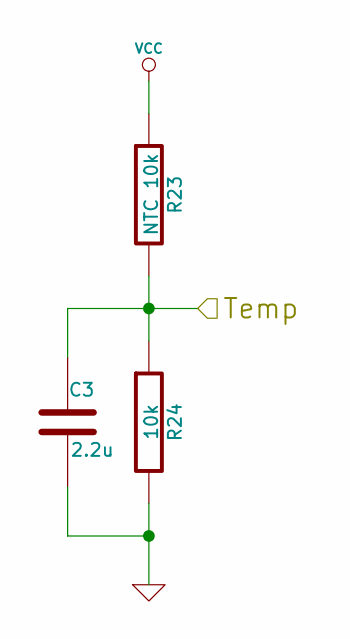
[picture p39: schematic temp.sch, NTC resistor temperature sensor]

Parts:
C3: 2.2u; SMD-0603_c
R23: NTC 10k; SMD-0603_r
R24: 10k; SMD-0603_r

Connections:
/MCU/ADC_TEMP: C3.1, R23.2, R24.1; also elsewhere on the board
GND: C3.2, R24.2; also elsewhere on the board
VCC: R23.1; also elsewhere on the board

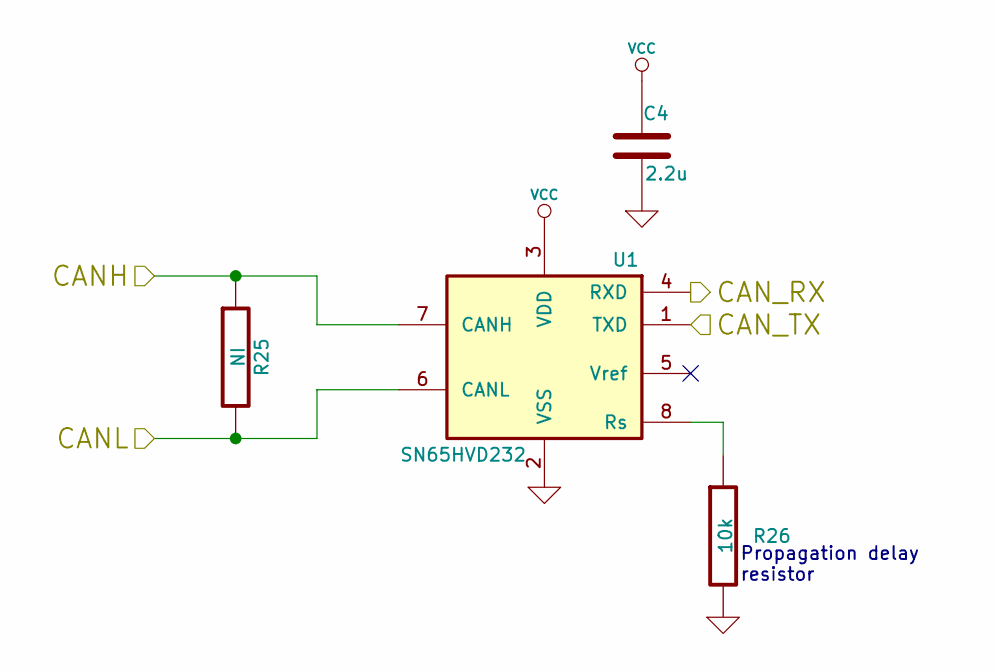
[picture p40: schematic CAN.sch, CAN BUS transceiver]

Parts:
C4: 2.2u; SMD-0402
R25: NI; SMD-0603_r
R26: 10k; SMD-0603_r
U1: SN65HVD232; SOIC-8-W

Connections:
/CAN bus transceiver/CANH: R25.1, U1.7 (CANH); also elsewhere on the board
/CAN bus transceiver/CANL: R25.2, U1.6 (CANL); also elsewhere on the board
/CAN bus transceiver/CAN_RX: U1.4 (RXD); also elsewhere on the board
/CAN bus transceiver/CAN_TX: U1.1 (TXD); also elsewhere on the board
GND: C4.2, R26.2, U1.2 (VSS); also elsewhere on the board
unnamed: R26.1, U1.8 (Rs)
VCC: C4.1, U1.3 (VDD); also elsewhere on the board

Notes on the sheet:
Propagation delay resistor

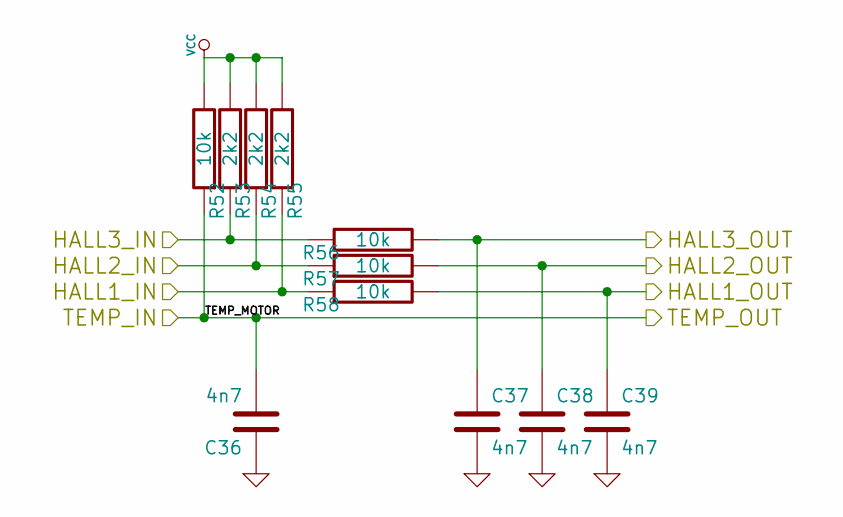
[picture p41: schematic hall_filters.sch]

Parts:
C5, C6, C7, C8: 4n7; SMD-0603_c
R27, R31, R32, R33: 10k; SMD-0603_r
R28, R29, R30: 2k2; SMD-0603_r

Connections:
/Filters/HALL1_IN: R30.1, R33.1; also elsewhere on the board
/Filters/HALL1_OUT: C8.1, R33.2; also elsewhere on the board
/Filters/HALL2_IN: R29.1, R32.1; also elsewhere on the board
/Filters/HALL2_OUT: C7.1, R32.2; also elsewhere on the board
/Filters/HALL3_IN: R28.1, R31.1; also elsewhere on the board
/Filters/HALL3_OUT: C6.1, R31.2; also elsewhere on the board
/Filters/TEMP_IN: C5.2, R27.1; also elsewhere on the board
GND: C5.1, C6.2, C7.2, C8.2; also elsewhere on the board
VCC: R27.2, R28.2, R29.2, R30.2; also elsewhere on the board

Parts of its further copies:
C36, C37, C38, C39: 4n7; SMD-0603_c
R52, R56, R57, R58: 10k; SMD-0603_r
R53, R54, R55: 2k2; SMD-0603_r

Connections of its further copies:
/Filters_2/HALL1_IN: R55.1, R58.1; also elsewhere on the board
/Filters_2/HALL1_OUT: C39.1, R58.2; also elsewhere on the board
/Filters_2/HALL2_IN: R54.1, R57.1; also elsewhere on the board
/Filters_2/HALL2_OUT: C38.1, R57.2; also elsewhere on the board
/Filters_2/HALL3_IN: R53.1, R56.1; also elsewhere on the board
/Filters_2/HALL3_OUT: C37.1, R56.2; also elsewhere on the board
/Filters_2/TEMP_IN: C36.2, R52.1; also elsewhere on the board
GND: C36.1, C37.2, C38.2, C39.2; also elsewhere on the board
VCC: R52.2, R53.2, R54.2, R55.2; also elsewhere on the board

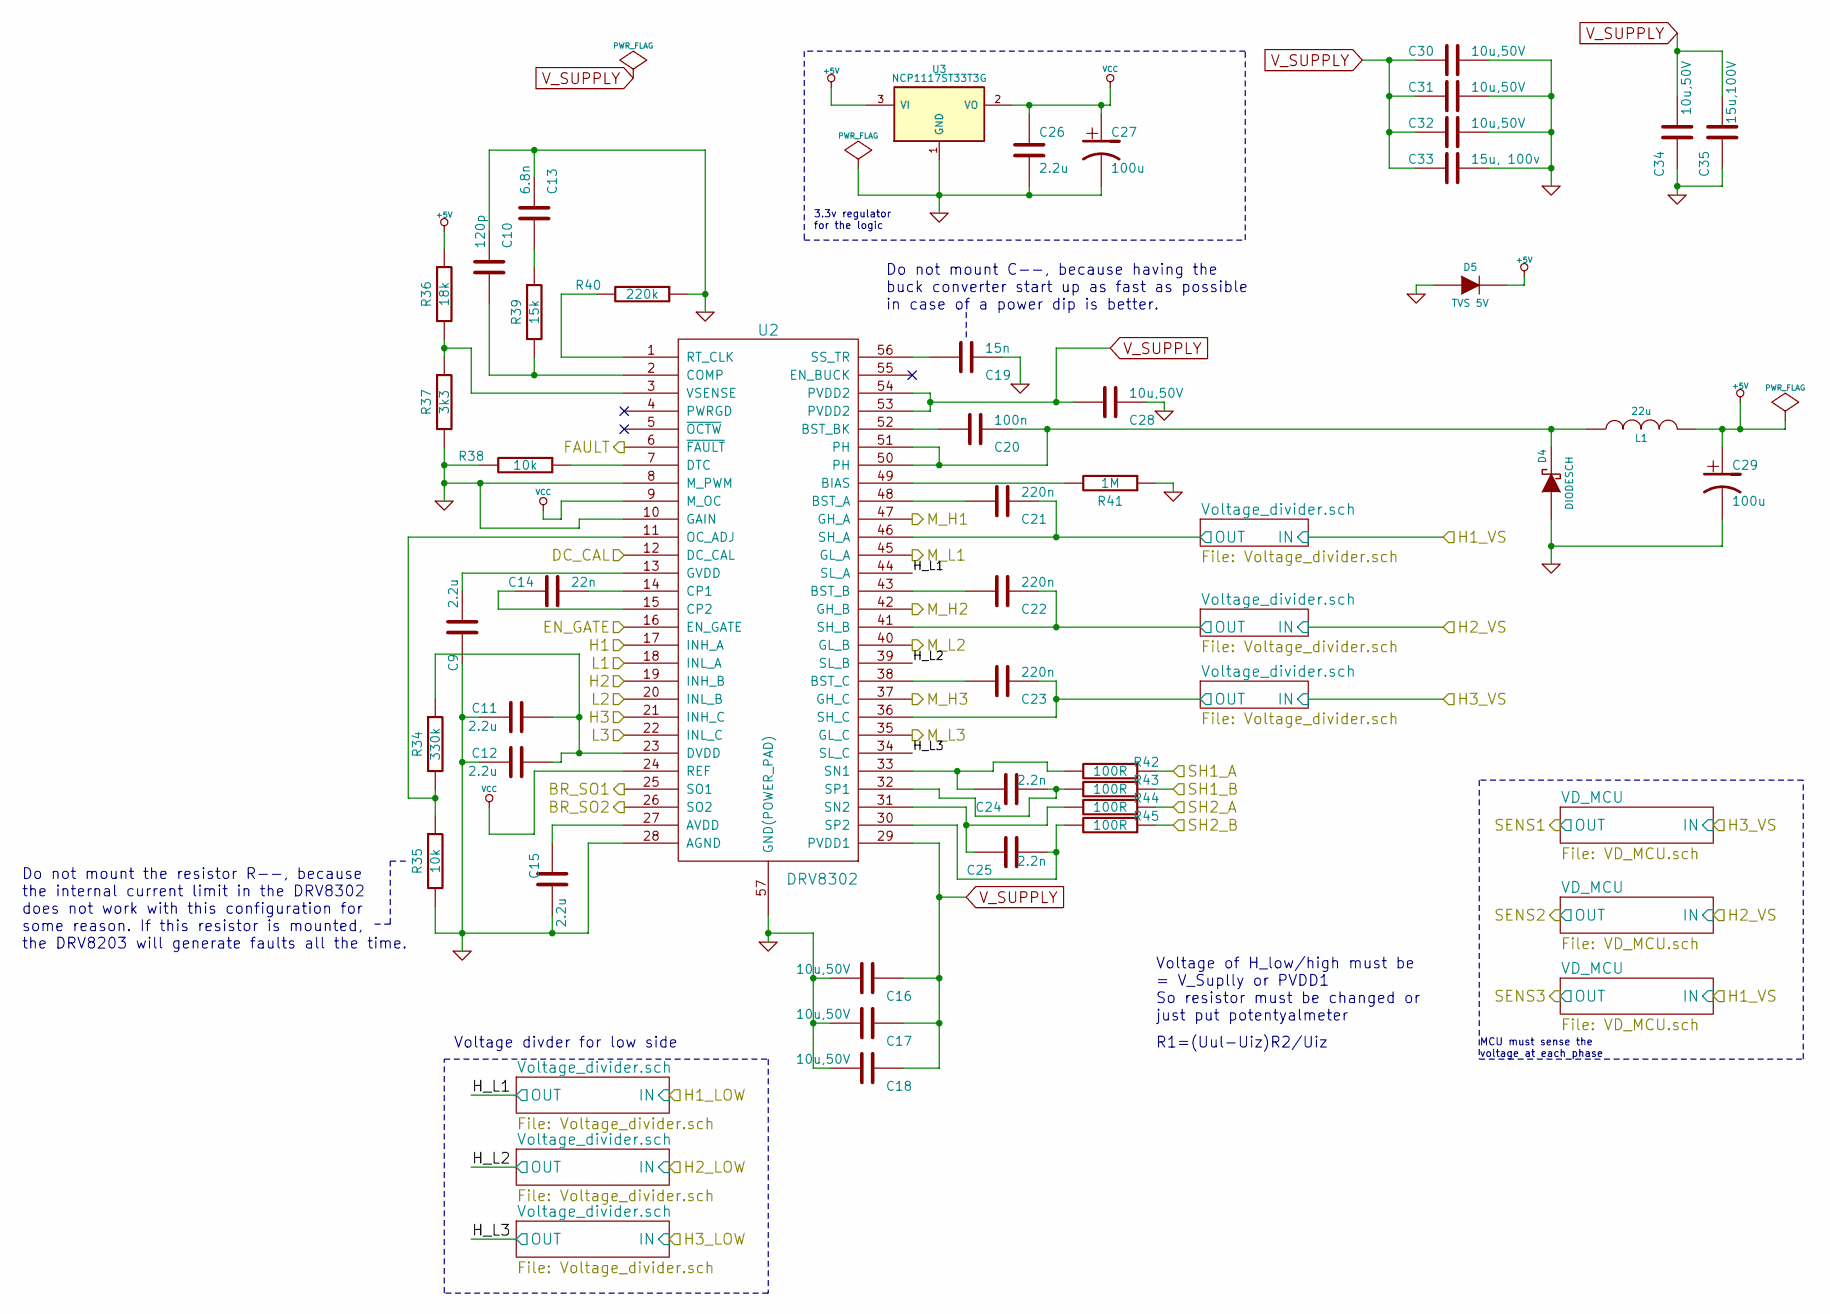
[picture p42: schematic Power.sch, BLDC Driver 4.5]

Parts:
C9, C15: 2.2u; SMD-0805
C10: 120p; SMD-0603_c
C11, C12, C26: 2.2u; SMD-0603_c
C13: 6.8n; SMD-0603_c
C14: 22n; SMD-0603_c
C16, C17, C18, C28, C30, C31, C32, C34: 10u,50V; SMD-1206
C19: 15n; SMD-0603_c
C20: 100n; SMD-0603_c
C21, C22, C23: 220n; SMD-0805
C24, C25: 2.2n; SMD-0603_c
C27, C29: 100u; c_tant_B
C33: 15u, 100v; c_2220
C35: 15u,100V; c_2220
D4: DIODESCH; Diode-SMA_Handsoldering
D5: TVS 5V; do214ac
L1: 22u; inductor_smd_8x5mm
R34: 330k; SMD-0603_r
R35, R38: 10k; SMD-0603_r
R36: 18k; SMD-0603_r
R37: 3k3; SMD-0603_r
R39: 15k; SMD-0603_r
R40: 220k; SMD-0603_r
R41: 1M; SMD-0603_r
R42, R43, R44, R45: 100R; SMD-0603_r
U2: DRV8302; TSSOP-56-PP
U3: NCP1117ST33T3G; SOT-223

Connections:
+5V: C29.1, D5.2 (K), L1.2, R36.1, U3.3 (VI); also elsewhere on the board
/Mosfet driver/BR_SO1: U2.25 (SO1); also elsewhere on the board
/Mosfet driver/BR_SO2: U2.26 (SO2); also elsewhere on the board
/Mosfet driver/DC_CAL: U2.12 (DC_CAL); also elsewhere on the board
/Mosfet driver/EN_GATE: U2.16 (EN_GATE); also elsewhere on the board
/Mosfet driver/FAULT: U2.6 (~FAULT); also elsewhere on the board
/Mosfet driver/H1: U2.17 (INH_A); also elsewhere on the board
/Mosfet driver/H2: U2.19 (INH_B); also elsewhere on the board
/Mosfet driver/H3: U2.21 (INH_C); also elsewhere on the board
/Mosfet driver/L1: U2.18 (INL_A); also elsewhere on the board
/Mosfet driver/L2: U2.20 (INL_B); also elsewhere on the board
/Mosfet driver/L3: U2.22 (INL_C); also elsewhere on the board
/Mosfet driver/M_H1: U2.47 (GH_A); also elsewhere on the board
/Mosfet driver/M_H2: U2.42 (GH_B); also elsewhere on the board
/Mosfet driver/M_H3: U2.37 (GH_C); also elsewhere on the board
/Mosfet driver/M_L1: U2.45 (GL_A); also elsewhere on the board
/Mosfet driver/M_L2: U2.40 (GL_B); also elsewhere on the board
/Mosfet driver/M_L3: U2.35 (GL_C); also elsewhere on the board
/Mosfet driver/SH1_A: R42.1; also elsewhere on the board
/Mosfet driver/SH1_B: R43.1; also elsewhere on the board
/Mosfet driver/SH2_A: R44.1; also elsewhere on the board
/Mosfet driver/SH2_B: R45.1; also elsewhere on the board
/Mosfet driver/Voltage_divider.sch/OUT: C21.1, C22.1, C23.1, U2.34 (SL_C), U2.36 (SH_C), U2.39 (SL_B), U2.41 (SH_B), U2.44 (SL_A), U2.46 (SH_A); also elsewhere on the board
GND: C9.2, C10.1, C11.1, C12.1, C13.1, C15.1, C16.2, C17.2, C18.2, C19.1, C26.2, C27.2, C28.1, C29.2, C30.1, C31.1, C32.1, C33.1, C34.1, C35.1, D4.1 (A), D5.1 (A), R35.2, R37.2, R38.2, R40.1, R41.1, U2.8 (M_PWM), U2.10 (GAIN), U2.28 (AGND), U2.57 (GND(POWER_PAD)), U3.1 (GND); also elsewhere on the board
unnamed: C9.1, U2.13 (GVDD)
unnamed: C10.2, R39.2, U2.2 (COMP)
unnamed: C11.2, C12.2, R34.1, U2.23 (DVDD)
unnamed: C13.2, R39.1
unnamed: C14.1, U2.14 (CP1)
unnamed: C14.2, U2.15 (CP2)
unnamed: C15.2, U2.27 (AVDD)
unnamed: C19.2, U2.56 (SS_TR)
unnamed: C20.1, D4.2 (K), L1.1, U2.50 (PH), U2.51 (PH)
unnamed: C20.2, U2.52 (BST_BK)
unnamed: C21.2, U2.48 (BST_A)
unnamed: C22.2, U2.43 (BST_B)
unnamed: C23.2, U2.38 (BST_C)
unnamed: C24.1, R42.2, U2.33 (SN1)
unnamed: C24.2, R43.2, U2.32 (SP1)
unnamed: C25.1, R44.2, U2.31 (SN2)
unnamed: C25.2, R45.2, U2.30 (SP2)
unnamed: R34.2, R35.1, U2.11 (OC_ADJ)
unnamed: R36.2, R37.1, U2.3 (VSENSE)
unnamed: R38.1, U2.7 (DTC)
unnamed: R40.2, U2.1 (RT_CLK)
unnamed: R41.2, U2.49 (BIAS)
VCC: C26.1, C27.1, U2.9 (M_OC), U2.24 (REF), U3.2 (VO); also elsewhere on the board
V_SUPPLY: C16.1, C17.1, C18.1, C28.2, C30.2, C31.2, C32.2, C33.2, C34.2, C35.2, U2.29 (PVDD1), U2.53 (PVDD2), U2.54 (PVDD2); also elsewhere on the board

Parts of its further copies:
C52, C58: 2.2u; SMD-0805
C53: 120p; SMD-0603_c
C54, C55, C69: 2.2u; SMD-0603_c
C56: 6.8n; SMD-0603_c
C57: 22n; SMD-0603_c
C59, C60, C61, C71, C73, C74, C75, C77: 10u,50V; SMD-1206
C62: 15n; SMD-0603_c
C63: 100n; SMD-0603_c
C64, C65, C66: 220n; SMD-0805
C67, C68: 2.2n; SMD-0603_c
C70, C72: 100u; c_tant_B
C76: 15u, 100v; c_2220
C78: 15u,100V; c_2220
D6: DIODESCH; Diode-SMA_Handsoldering
D7: TVS 5V; do214ac
L2: 22u; inductor_smd_8x5mm
R68: 330k; SMD-0603_r
R69, R72: 10k; SMD-0603_r
R70: 18k; SMD-0603_r
R71: 3k3; SMD-0603_r
R73: 15k; SMD-0603_r
R74: 220k; SMD-0603_r
R75: 1M; SMD-0603_r
R76, R77, R78, R79: 100R; SMD-0603_r
U5: DRV8302; TSSOP-56-PP
U6: NCP1117ST33T3G; SOT-223

Connections of its further copies:
+5V: C72.1, D7.2 (K), L2.2, R70.1, U6.3 (VI); also elsewhere on the board
/Mosfet driver_2/BR_SO1: U5.25 (SO1); also elsewhere on the board
/Mosfet driver_2/BR_SO2: U5.26 (SO2); also elsewhere on the board
/Mosfet driver_2/DC_CAL: U5.12 (DC_CAL); also elsewhere on the board
/Mosfet driver_2/EN_GATE: U5.16 (EN_GATE); also elsewhere on the board
/Mosfet driver_2/FAULT: U5.6 (~FAULT); also elsewhere on the board
/Mosfet driver_2/H1: U5.17 (INH_A); also elsewhere on the board
/Mosfet driver_2/H2: U5.19 (INH_B); also elsewhere on the board
/Mosfet driver_2/H3: U5.21 (INH_C); also elsewhere on the board
/Mosfet driver_2/L1: U5.18 (INL_A); also elsewhere on the board
/Mosfet driver_2/L2: U5.20 (INL_B); also elsewhere on the board
/Mosfet driver_2/L3: U5.22 (INL_C); also elsewhere on the board
/Mosfet driver_2/M_H1: U5.47 (GH_A); also elsewhere on the board
/Mosfet driver_2/M_H2: U5.42 (GH_B); also elsewhere on the board
/Mosfet driver_2/M_H3: U5.37 (GH_C); also elsewhere on the board
/Mosfet driver_2/M_L1: U5.45 (GL_A); also elsewhere on the board
/Mosfet driver_2/M_L2: U5.40 (GL_B); also elsewhere on the board
/Mosfet driver_2/M_L3: U5.35 (GL_C); also elsewhere on the board
/Mosfet driver_2/SH1_A: R76.1; also elsewhere on the board
/Mosfet driver_2/SH1_B: R77.1; also elsewhere on the board
/Mosfet driver_2/SH2_A: R78.1; also elsewhere on the board
/Mosfet driver_2/SH2_B: R79.1; also elsewhere on the board
/Mosfet driver_2/Voltage_divider.sch/OUT: C64.1, C65.1, C66.1, U5.34 (SL_C), U5.36 (SH_C), U5.39 (SL_B), U5.41 (SH_B), U5.44 (SL_A), U5.46 (SH_A); also elsewhere on the board
GND: C52.2, C53.1, C54.1, C55.1, C56.1, C58.1, C59.2, C60.2, C61.2, C62.1, C69.2, C70.2, C71.1, C72.2, C73.1, C74.1, C75.1, C76.1, C77.1, C78.1, D6.1 (A), D7.1 (A), R69.2, R71.2, R72.2, R74.1, R75.1, U5.8 (M_PWM), U5.10 (GAIN), U5.28 (AGND), U5.57 (GND(POWER_PAD)), U6.1 (GND); also elsewhere on the board
unnamed: C52.1, U5.13 (GVDD)
unnamed: C53.2, R73.2, U5.2 (COMP)
unnamed: C54.2, C55.2, R68.1, U5.23 (DVDD)
unnamed: C56.2, R73.1
unnamed: C57.1, U5.14 (CP1)
unnamed: C57.2, U5.15 (CP2)
unnamed: C58.2, U5.27 (AVDD)
unnamed: C62.2, U5.56 (SS_TR)
unnamed: C63.1, D6.2 (K), L2.1, U5.50 (PH), U5.51 (PH)
unnamed: C63.2, U5.52 (BST_BK)
unnamed: C64.2, U5.48 (BST_A)
unnamed: C65.2, U5.43 (BST_B)
unnamed: C66.2, U5.38 (BST_C)
unnamed: C67.1, R76.2, U5.33 (SN1)
unnamed: C67.2, R77.2, U5.32 (SP1)
unnamed: C68.1, R78.2, U5.31 (SN2)
unnamed: C68.2, R79.2, U5.30 (SP2)
unnamed: R68.2, R69.1, U5.11 (OC_ADJ)
unnamed: R70.2, R71.1, U5.3 (VSENSE)
unnamed: R72.1, U5.7 (DTC)
unnamed: R74.2, U5.1 (RT_CLK)
unnamed: R75.2, U5.49 (BIAS)
VCC: C69.1, C70.1, U5.9 (M_OC), U5.24 (REF), U6.2 (VO); also elsewhere on the board
V_SUPPLY: C59.1, C60.1, C61.1, C71.2, C73.2, C74.2, C75.2, C76.2, C77.2, C78.2, U5.29 (PVDD1), U5.53 (PVDD2), U5.54 (PVDD2); also elsewhere on the board

Notes on the sheet:
MCU must sense the voltage at each phase
3.3v regulator for the logic
Do not mount the resistor R--, because the internal current limit in the DRV8302 does not work with this configuration for some reason. If this resistor is mounted, the DRV8203 will generate faults all the time.
Do not mount C--, because having the buck converter start up as fast as possible in case of a power dip is better.
Voltage of H_low/high must be = V_Suplly or PVDD1 So resistor must be changed or just put potentyalmeter
Voltage divder for low side
R1=(Uul-Uiz)R2/Uiz
