glocklueng/bldc-hardware/design/BLDC_4.kicad_pcb

## KiCad design design/BLDC_4.kicad_pcb (continued)

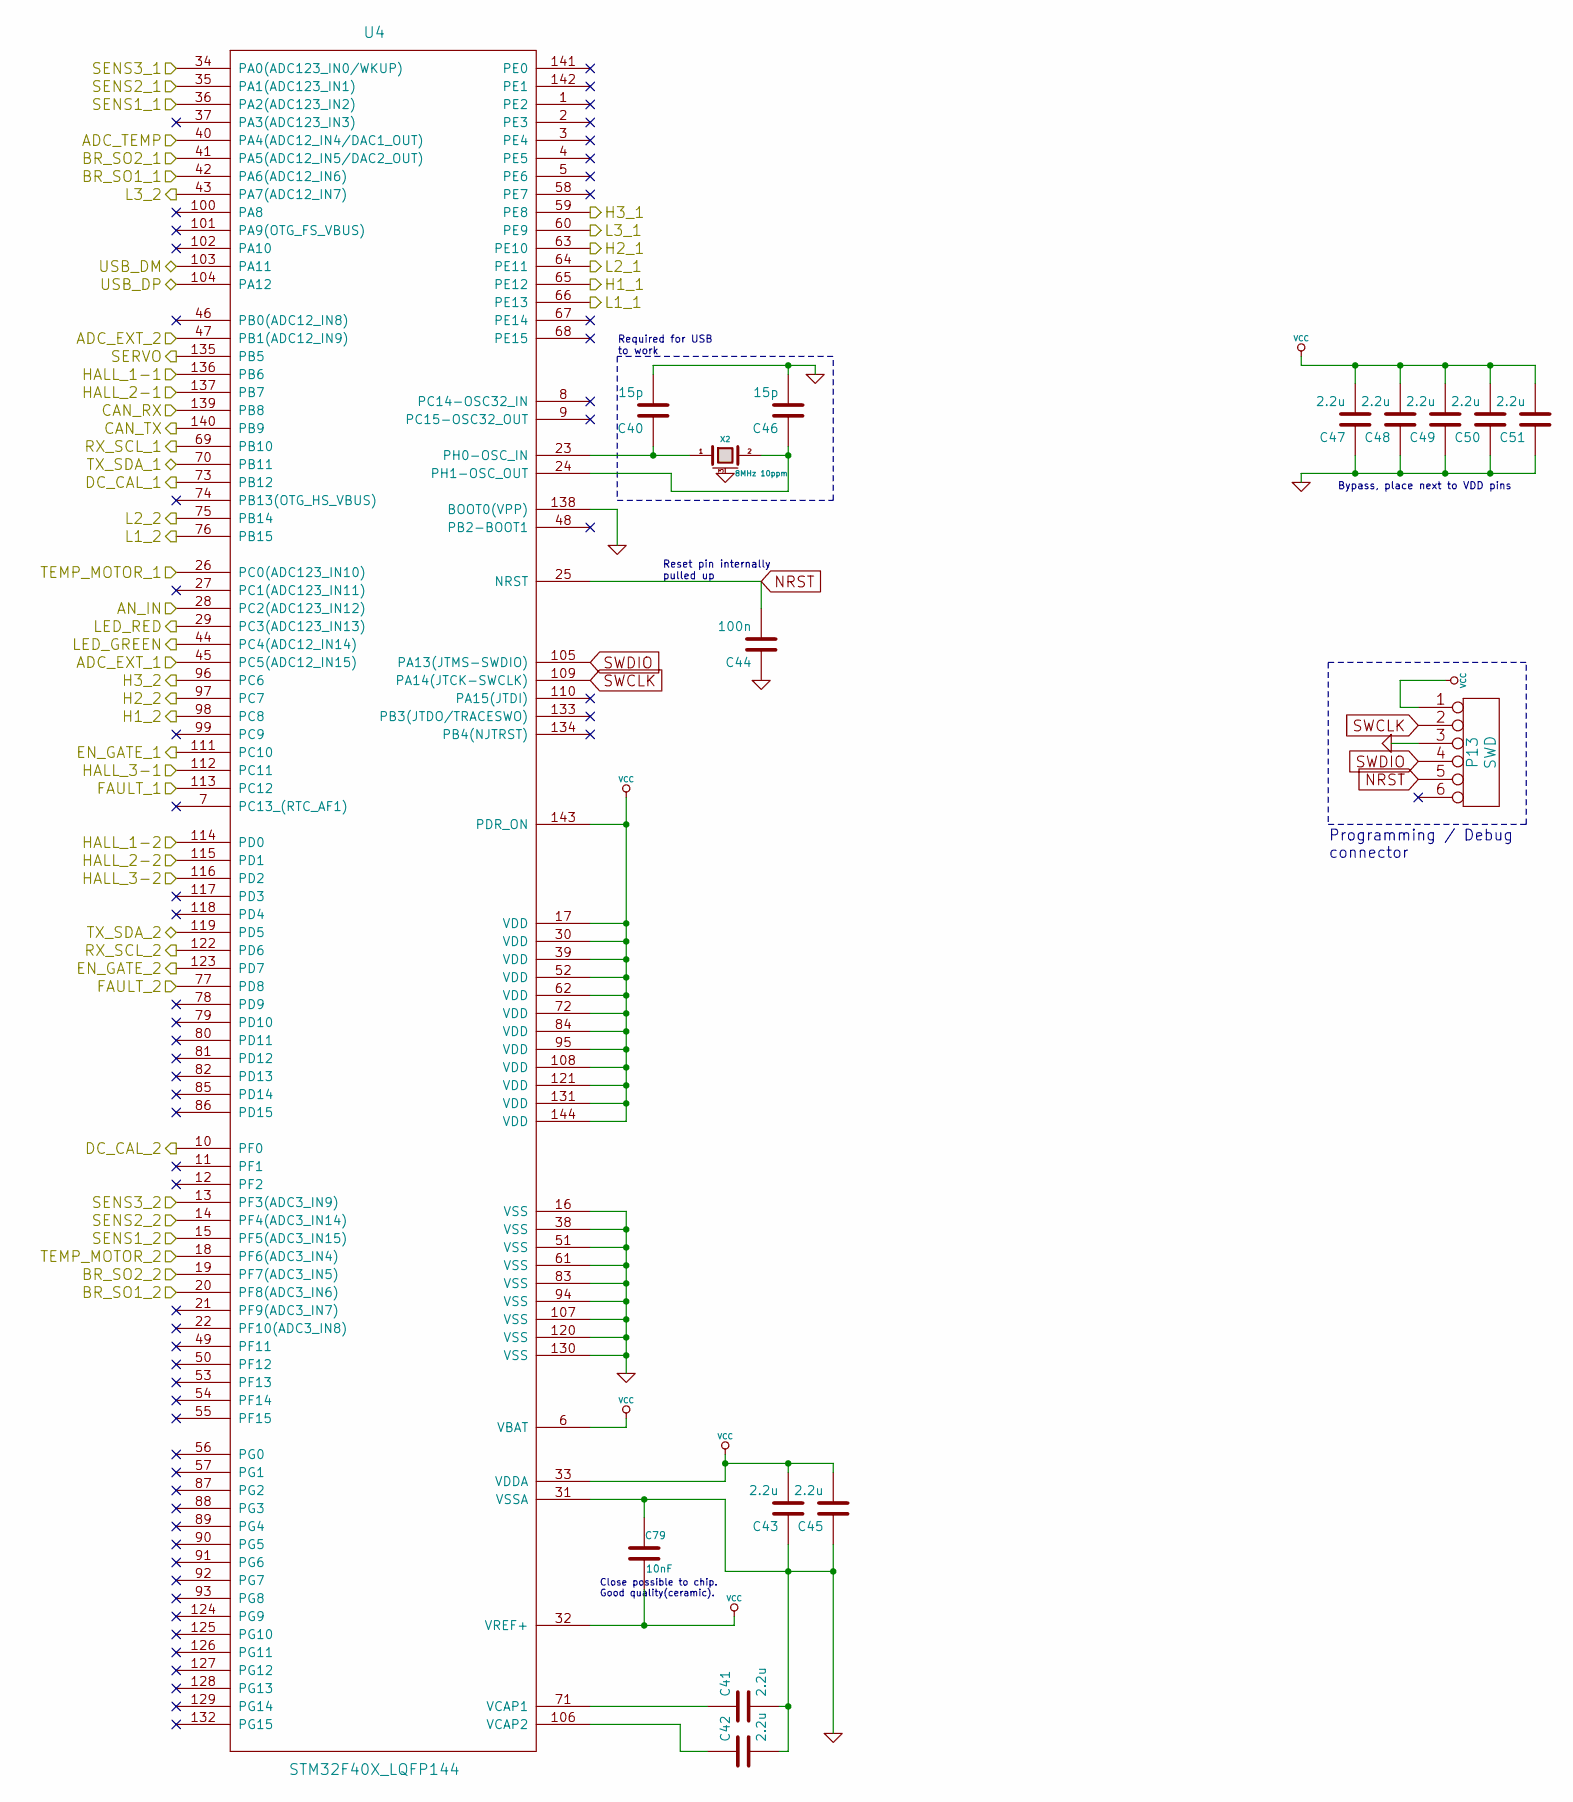
[picture p43: schematic STM32F4_144LQFP.sch, BLDC Driver 4.6]

Parts:
C40, C46: 15p; SMD-0603_c
C41, C42, C43, C45, C47, C48, C49, C50, C51: 2.2u; SMD-0603_c
C44: 100n; SMD-0603_c
C79: 10nF; SMD-0603_c
P13: SWD; MICRO_JST_6
U4: STM32F40X_LQFP144; TQFP-144_20x20mm_Pitch0.5mm
X2: 8MHz 10ppm; Crystal_5x3mm; mfg# ABM3B-8.0-10-1UT

Connections:
/CAN bus transceiver/CAN_RX: U4.139 (PB8); also elsewhere on the board
/CAN bus transceiver/CAN_TX: U4.140 (PB9); also elsewhere on the board
/Filters/HALL1_OUT: U4.136 (PB6); also elsewhere on the board
/Filters/HALL2_OUT: U4.137 (PB7); also elsewhere on the board
/Filters/HALL3_OUT: U4.112 (PC11); also elsewhere on the board
/Filters/TEMP_IN: U4.26 (PC0(ADC123_IN10)); also elsewhere on the board
/Filters_2/HALL1_OUT: U4.114 (PD0); also elsewhere on the board
/Filters_2/HALL2_OUT: U4.115 (PD1); also elsewhere on the board
/Filters_2/HALL3_OUT: U4.116 (PD2); also elsewhere on the board
/Filters_2/TEMP_IN: U4.18 (PF6(ADC3_IN4)); also elsewhere on the board
/MCU/ADC_EXT_1: U4.45 (PC5(ADC12_IN15)); also elsewhere on the board
/MCU/ADC_EXT_2: U4.47 (PB1(ADC12_IN9)); also elsewhere on the board
/MCU/ADC_TEMP: U4.40 (PA4(ADC12_IN4/DAC1_OUT)); also elsewhere on the board
/MCU/AN_IN: U4.28 (PC2(ADC123_IN12)); also elsewhere on the board
/MCU/LED_GREEN: U4.44 (PC4(ADC12_IN14)); also elsewhere on the board
/MCU/LED_RED: U4.29 (PC3(ADC123_IN13)); also elsewhere on the board
/MCU/RX_SCL_1: U4.69 (PB10); also elsewhere on the board
/MCU/RX_SCL_2: U4.122 (PD6); also elsewhere on the board
/MCU/SERVO: U4.135 (PB5); also elsewhere on the board
/MCU/TX_SDA_1: U4.70 (PB11); also elsewhere on the board
/MCU/TX_SDA_2: U4.119 (PD5); also elsewhere on the board
/MCU/USB_DM: U4.103 (PA11); also elsewhere on the board
/MCU/USB_DP: U4.104 (PA12); also elsewhere on the board
/Mosfet driver/BR_SO1: U4.42 (PA6(ADC12_IN6)); also elsewhere on the board
/Mosfet driver/BR_SO2: U4.41 (PA5(ADC12_IN5/DAC2_OUT)); also elsewhere on the board
/Mosfet driver/DC_CAL: U4.73 (PB12); also elsewhere on the board
/Mosfet driver/EN_GATE: U4.111 (PC10); also elsewhere on the board
/Mosfet driver/FAULT: U4.113 (PC12); also elsewhere on the board
/Mosfet driver/H1: U4.65 (PE12); also elsewhere on the board
/Mosfet driver/H2: U4.63 (PE10); also elsewhere on the board
/Mosfet driver/H3: U4.59 (PE8); also elsewhere on the board
/Mosfet driver/L1: U4.66 (PE13); also elsewhere on the board
/Mosfet driver/L2: U4.64 (PE11); also elsewhere on the board
/Mosfet driver/L3: U4.60 (PE9); also elsewhere on the board
/Mosfet driver/SENS1: U4.36 (PA2(ADC123_IN2)); also elsewhere on the board
/Mosfet driver/SENS2: U4.35 (PA1(ADC123_IN1)); also elsewhere on the board
/Mosfet driver/SENS3: U4.34 (PA0(ADC123_IN0/WKUP)); also elsewhere on the board
/Mosfet driver_2/BR_SO1: U4.20 (PF8(ADC3_IN6)); also elsewhere on the board
/Mosfet driver_2/BR_SO2: U4.19 (PF7(ADC3_IN5)); also elsewhere on the board
/Mosfet driver_2/DC_CAL: U4.10 (PF0); also elsewhere on the board
/Mosfet driver_2/EN_GATE: U4.123 (PD7); also elsewhere on the board
/Mosfet driver_2/FAULT: U4.77 (PD8); also elsewhere on the board
/Mosfet driver_2/H1: U4.98 (PC8); also elsewhere on the board
/Mosfet driver_2/H2: U4.97 (PC7); also elsewhere on the board
/Mosfet driver_2/H3: U4.96 (PC6); also elsewhere on the board
/Mosfet driver_2/L1: U4.76 (PB15); also elsewhere on the board
/Mosfet driver_2/L2: U4.75 (PB14); also elsewhere on the board
/Mosfet driver_2/L3: U4.43 (PA7(ADC12_IN7)); also elsewhere on the board
/Mosfet driver_2/SENS1: U4.15 (PF5(ADC3_IN15)); also elsewhere on the board
/Mosfet driver_2/SENS2: U4.14 (PF4(ADC3_IN14)); also elsewhere on the board
/Mosfet driver_2/SENS3: U4.13 (PF3(ADC3_IN9)); also elsewhere on the board
GND: C40.2, C41.2, C42.2, C43.1, C44.1, C45.1, C46.2, C47.1, C48.1, C49.1, C50.1, C51.1, C79.1, P13.3, U4.16 (VSS), U4.31 (VSSA), U4.38 (VSS), U4.51 (VSS), U4.61 (VSS), U4.83 (VSS), U4.94 (VSS), U4.107 (VSS), U4.120 (VSS), U4.130 (VSS), U4.138 (BOOT0(VPP)), X2.3 (case); also elsewhere on the board
NRST: C44.2, P13.5, U4.25 (NRST)
unnamed: C40.1, U4.23 (PH0-OSC_IN), X2.1
unnamed: C41.1, U4.71 (VCAP1)
unnamed: C42.1, U4.106 (VCAP2)
unnamed: C46.1, U4.24 (PH1-OSC_OUT), X2.2
SWCLK: P13.2, U4.109 (PA14(JTCK-SWCLK))
SWDIO: P13.4, U4.105 (PA13(JTMS-SWDIO))
VCC: C43.2, C45.2, C47.2, C48.2, C49.2, C50.2, C51.2, C79.2, P13.1, U4.6 (VBAT), U4.17 (VDD), U4.30 (VDD), U4.32 (VREF+), U4.33 (VDDA), U4.39 (VDD), U4.52 (VDD), U4.62 (VDD), U4.72 (VDD), U4.84 (VDD), U4.95 (VDD), U4.108 (VDD), U4.121 (VDD), U4.131 (VDD), U4.143 (PDR_ON), U4.144 (VDD); also elsewhere on the board

Notes on the sheet:
Programming / Debug connector
Reset pin internally pulled up
Required for USB to work
Bypass, place next to VDD pins
Close possible to chip. Good quality(ceramic).

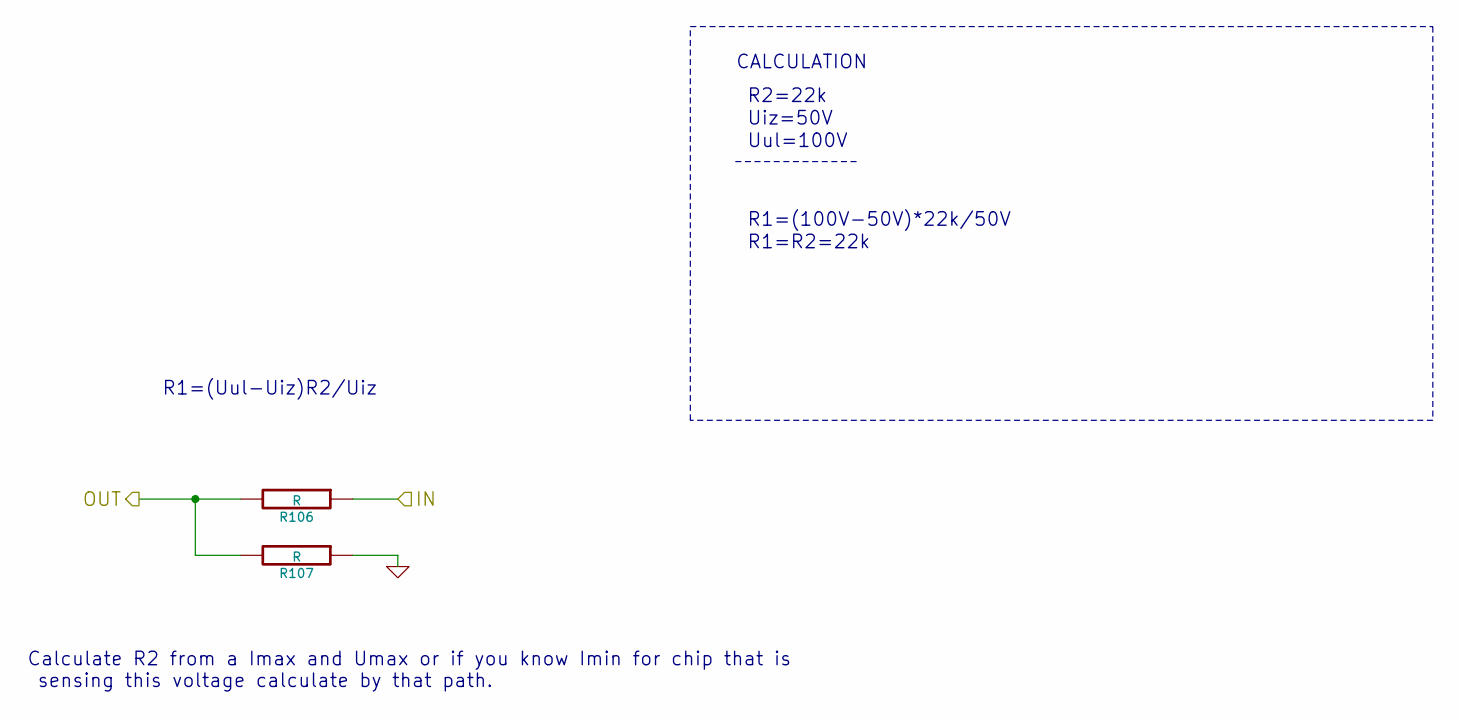
[picture p44: schematic Voltage_divider.sch]

Parts:
R92, R93: R

Connections:
/Mosfet driver/Voltage_divider.sch/OUT: R92.2, R93.2; also elsewhere on the board
GND: R93.1; also elsewhere on the board

Parts of its further copies:
R86, R87, R88, R89, R90, R91, R94, R95, R96, R97, R98, R99, R100, R101, R102, R103, R104, R105, R106, R107, R108, R109: R

Connections of its further copies:
/Mosfet driver/H3_VS: R90.1; also elsewhere on the board
/Mosfet driver/Voltage_divider.sch/OUT: R86.2, R87.2, R88.2, R89.2, R90.2, R91.2, R94.2, R95.2, R96.2, R97.2; also elsewhere on the board
/Mosfet driver_2/H3_VS: R102.1; also elsewhere on the board
/Mosfet driver_2/Voltage_divider.sch/OUT: R98.2, R99.2, R100.2, R101.2, R102.2, R103.2, R104.2, R105.2, R106.2, R107.2, R108.2, R109.2; also elsewhere on the board
GND: R87.1, R89.1, R91.1, R94.1, R95.1, R97.1, R99.1, R101.1, R103.1, R105.1, R106.1, R107.1, R109.1; also elsewhere on the board

Notes on the sheet:
R1=(Uul-Uiz)R2/Uiz
Calculate R2 from a Imax and Umax or if you know Imin for chip that is sensing this voltage calculate by that path.
CALCULATION
R2=22k
Uiz=50V
Uul=100V
R1=(100V-50V)*22k/50V
R1=R2=22k

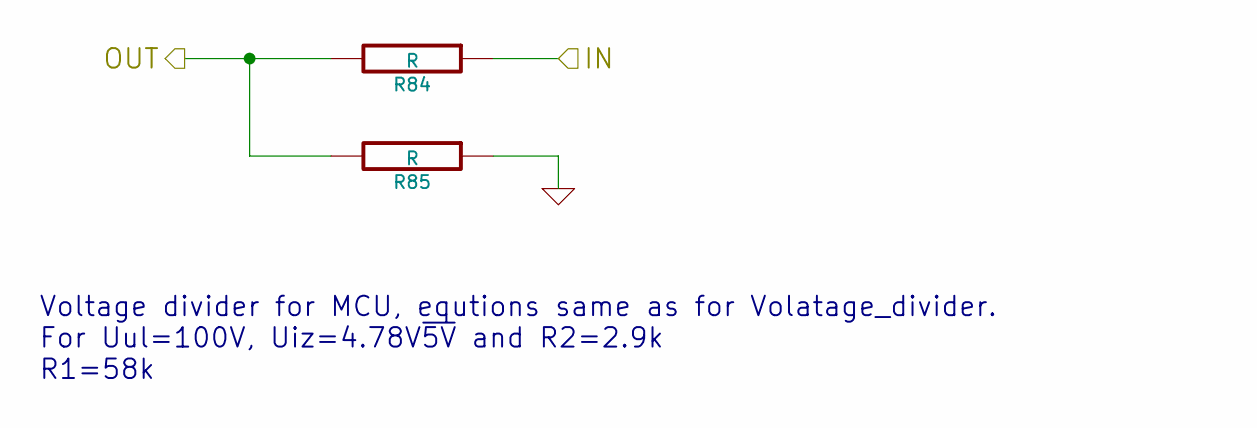
[picture p45: schematic VD_MCU.sch]

Parts:
R46, R47: R

Connections:
/Mosfet driver/H3_VS: R46.1; also elsewhere on the board
/Mosfet driver/SENS1: R46.2, R47.2; also elsewhere on the board
GND: R47.1; also elsewhere on the board

Parts of its further copies:
R48, R49, R50, R51, R80, R81, R82, R83, R84, R85: R

Connections of its further copies:
/Mosfet driver/SENS2: R48.2, R49.2; also elsewhere on the board
/Mosfet driver/SENS3: R50.2, R51.2; also elsewhere on the board
/Mosfet driver_2/H3_VS: R80.1; also elsewhere on the board
/Mosfet driver_2/SENS1: R80.2, R81.2; also elsewhere on the board
/Mosfet driver_2/SENS2: R82.2, R83.2; also elsewhere on the board
/Mosfet driver_2/SENS3: R84.2, R85.2; also elsewhere on the board
GND: R49.1, R51.1, R81.1, R83.1, R85.1; also elsewhere on the board

Notes on the sheet:
Voltage divider for MCU, equtions same as for Volatage_divider. For Uul=100V, Uiz=4.78V~5V and R2=2.9k R1=58k

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
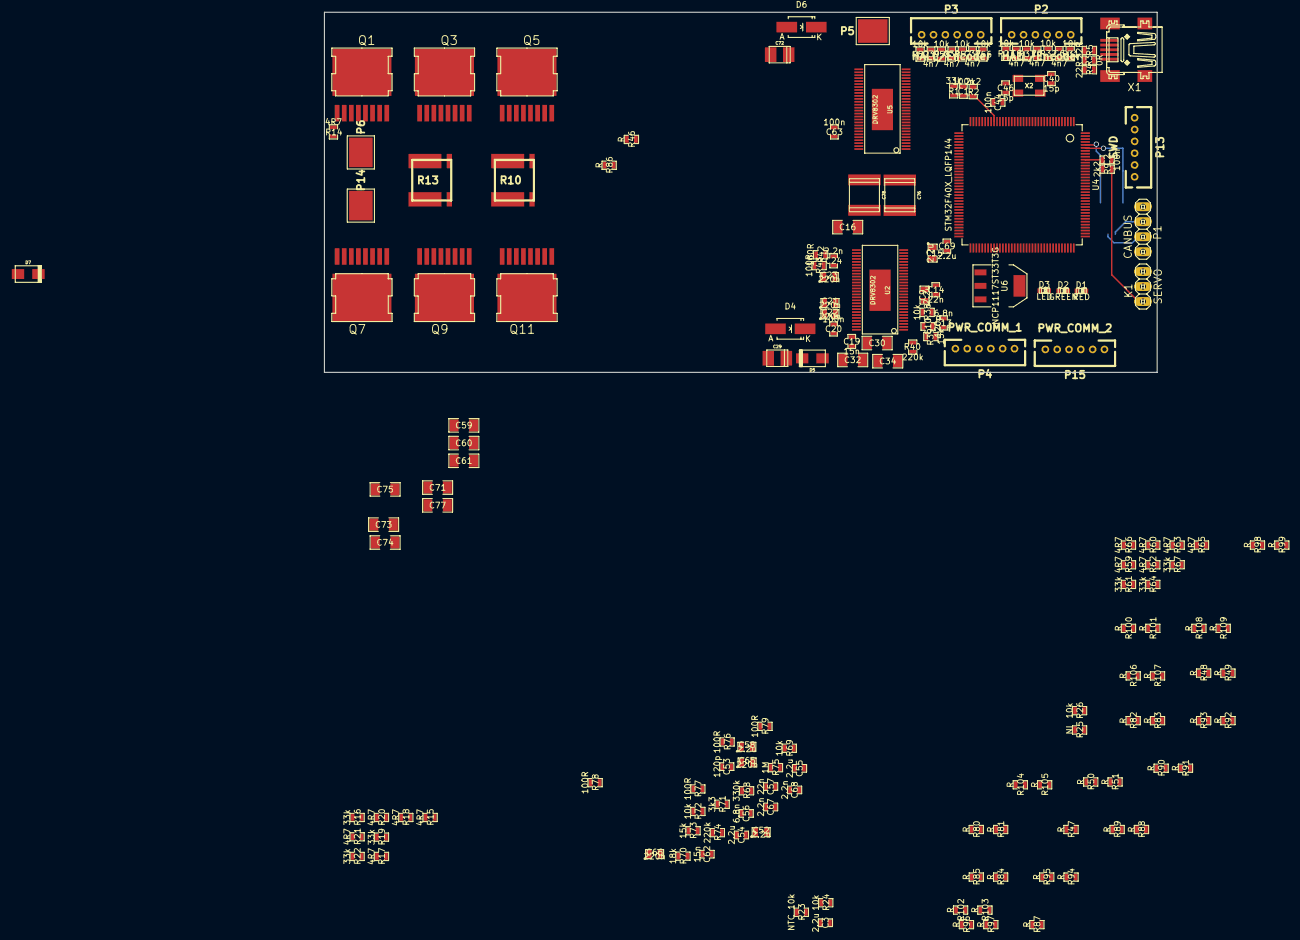
[picture p46: board BLDC_4.kicad_pcb from above]

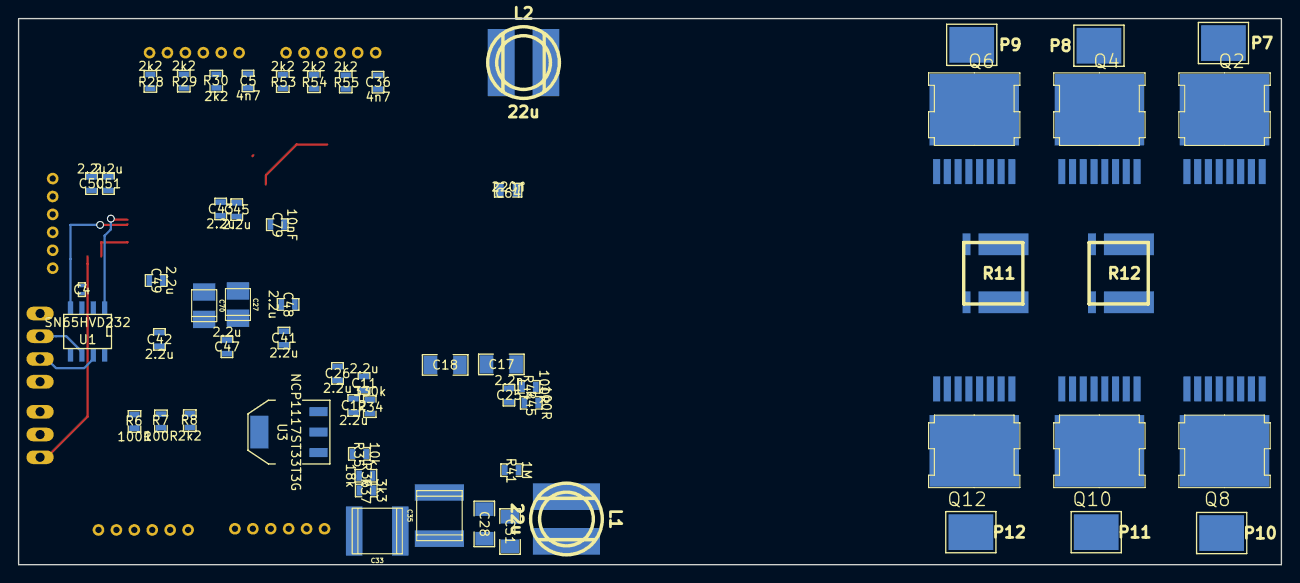
[picture p47: board BLDC_4.kicad_pcb from below]

Board: 4 copper layers, 141.0 x 61.0 mm, 233 parts (60 on the bottom side), 167 nets.
