glocklueng/bldc-hardware/(commit log)

2015-01-09 Add some MOSFET's tha could be good for our project
2015-01-10 Some small changes so i can understand and see better
    [CAN.sch, Power.sch, STM32F4 64LQFP.sch, hall_filters.sch, mosfets.sch, temp.sch]
2015-01-10 Add a new 144 to schematic and start working on it
    [BLDC_4.sch, STM32F4 144LQFP.sch]
2015-01-13 Add a electronic for second motor and add new pin's for it on MCU; TODO Add new mosfets
    [BLDC_4.kicad_pcb, BLDC_4.sch, CAN.sch, Power.sch, STM32F4 144LQFP.sch, STM32F4 64LQFP.sch, hall_filters.sch, mosfets.sch]
2015-01-16 Make a BOM + change .cmp so components match mine's libs
2015-01-16 Make change in annotations and some small fixes
    [BLDC_4.sch, CAN.sch, Power.sch, STM32F4 144LQFP.sch, STM32F4 64LQFP.sch, hall_filters.sch, mosfets.sch, temp.sch]
2015-01-16 Change names of sheets so there's no erc warnings, add pdf in color
    [BLDC_4.sch, Power.sch, STM32F4 144LQFP.sch, mosfets.sch]
2015-01-22 Change sheet for college and som in pdf
    [BLDC_4.sch, BOM_2.xls, CAN.sch, Power.sch, STM32F4 144LQFP.sch, hall_filters.sch, mosfets.sch, temp.sch]
2015-02-06 Add a voltage divider resistors for driver chip
    [BLDC_4.sch, CAN.sch, Power.sch, STM32F4 144LQFP.sch, hall_filters.sch, mosfets.sch, temp.sch]
2015-02-06 Declare mosfet supply
    [BLDC_4.sch, CAN.sch, Power.sch, STM32F4 144LQFP.sch, hall_filters.sch, mosfets.sch, temp.sch]
2015-02-08 Change libraries ot new pretty format
    [BLDC_4.sch, CAN.sch, Power.sch, STM32F4 144LQFP.sch, hall_filters.sch, mosfets.sch, temp.sch]
2015-02-13 Add pwr for second motor
    [BLDC_4.sch, CAN.sch, Power.sch, STM32F4_144LQFP.sch, hall_filters.sch, mosfets.sch, temp.sch]
2015-02-13 Voltage divider for DRV and MCU
    [BLDC_4.sch, Power.sch, VD_MCU.sch, Voltage_divider.sch]
2015-02-13 Fix some ERC error, add decoupling cap to Vref+ and make some small changes to lib
    [BLDC_4.sch, CAN.sch, Power.sch, STM32F4_144LQFP.sch, VD_MCU.sch, Voltage_divider.sch, hall_filters.sch, mosfets.sch]
2015-02-14 Start pcb
    [BLDC_4_old.kicad_pcb]
2015-02-14 Add led's lib
2015-02-14 Chnge name of crf lib and add footprint for new cap
    [STM32F4_144LQFP.sch]
2015-02-16 Some fixes in libs,schemas and netlist. Start new PCB
    [BLDC_4.kicad_pcb, BLDC_4.sch, STM32F4_144LQFP.sch]
2015-02-16 Footprint for mosfets and change them in schematics and in netlist
    [mosfets.sch]
2015-02-16 Start work on pcb
    [$Power.sch, $STM32F4_144LQFP.sch, BLDC_4.kicad_pcb, BLDC_4.sch]
2015-02-17 Layout all on pcb except some resitors
    [BLDC_4.kicad_pcb]
2015-02-17 Add all components
    [BLDC_4.kicad_pcb]
2015-02-17 Routing ... Maybe H_VS and other dividers are to close to chip and one another it's a 100V.
    [BLDC_4.kicad_pcb]
2015-02-25 New pcb layout
    [BLDC_4.kicad_pcb]
2015-03-04 New desing starting placment of components
    [BLDC_4.dsn, BLDC_4.kicad_pcb]
2015-03-07 More layouting
    [BLDC_4.kicad_pcb]
2015-05-14 Add a new driver this time and for IGBT
